sneakyginger/Silicone_dispenser/powerpoint/tussentijdse presentatie .pptx

## Silicone dispenser Gip midterm presentation

Piot David, Quackels Niels, Vandekerckhove Kamiel , Van Vlierberghe Gregor

## Introduction

- Probleemstelling : silicon gieten is vermoeiend .... Etc

Firw, Department of Mechanical Engineering

## Content

- Introduction
- Environment and constraints
- Functional decomposition
- Evaluation of ideas
- Current proposition
- Plan for after easter break

## Content

- Introduction
- Environment and constraints
- Functional decomposition
- Evaluation of ideas
- Current proposition
- Plan for semester

## Environment and constraints

- Wordt document met aannames en randvoorwaarden

## Content

- Introduction
- Environment and constraints
- Functional decomposition
- Evaluation of ideas
- Current proposition
- Plan for semester

## Functional decompostion

## Content

- Introduction
- Environment and constraints
- Functional decomposition
- Evaluation of ideas
- Current proposition
- Plan for semester 2

## Generating and Evaluating Ideas –

## Generating and Evaluating Ideas – Collection system

## Generating and Evaluating Ideas – Collection system

## Content

- Introduction
- Environment and constraints
- Functional decomposition
- Evaluation of ideas
- Current proposition
- Plan for semester 2

## Current Proposition

## Current Proposition

Temporarily closing

## Current Proposition

## Content

- Introduction
- Environment and constraints
- Functional decomposition
- Evaluation of ideas
- Current proposition
- Plan for semester 2

## Semester 2

- Dimensioning structures
- Specification of materials
- CAD modelling
- Detail presentation + final report and presentation
