sneakyginger/Silicone_dispenser/electronics/Presentation1.pptx

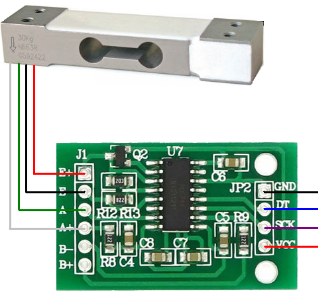
[picture p68: figure]
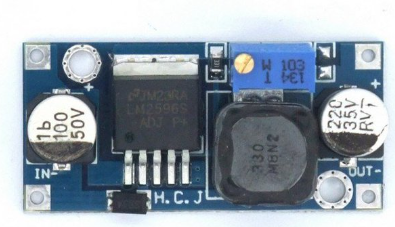
[picture p69: figure]
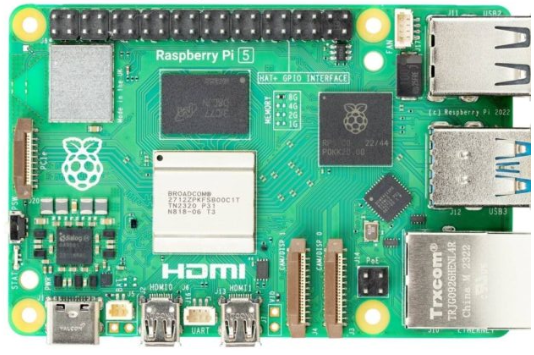
[picture p70: figure]
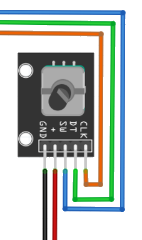
[picture p71: figure]
