sneakyginger/Silicone_dispenser/CAD/Electronics/Front_Perspective_1.JPG

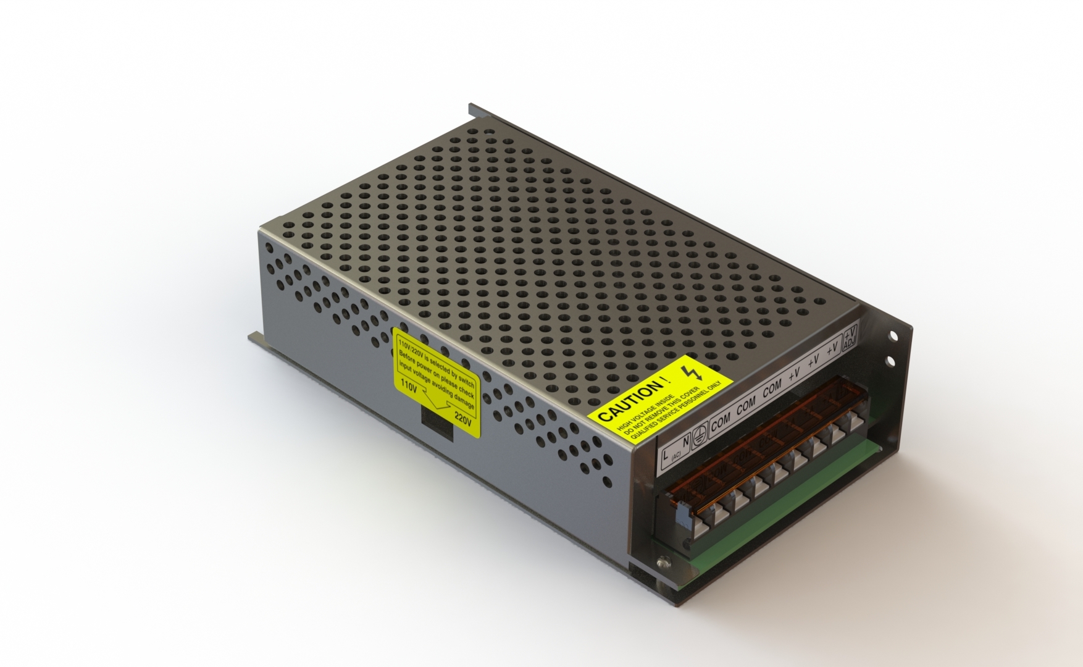
CAD/Electronics/Front_Perspective_1.JPG
