sneakyginger/Silicone_dispenser/CAD/Electronics/Lead Shine DM556.JPG

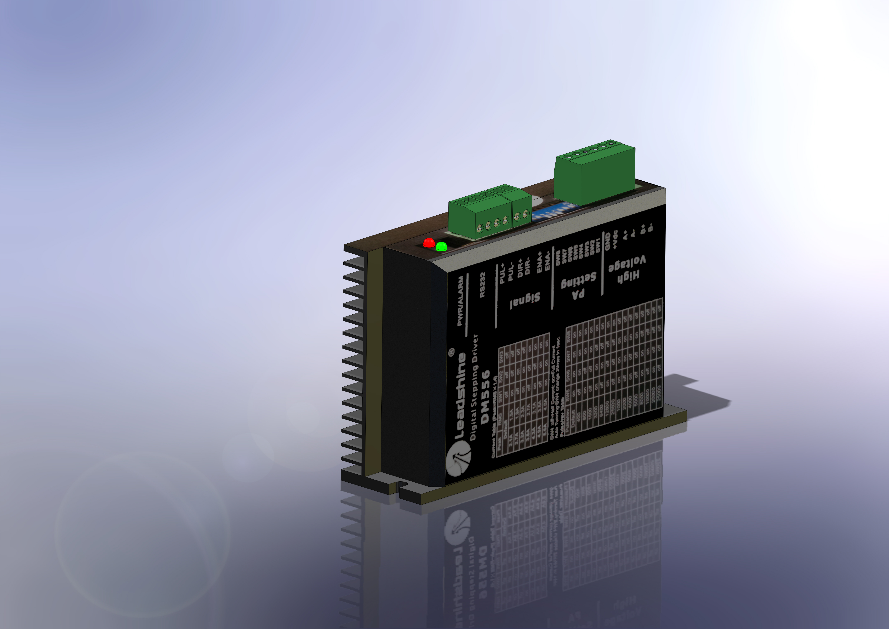
CAD/Electronics/Lead Shine DM556.JPG
