sneakyginger/Silicone_dispenser/CAD/Electronics/Rear_Perpective_2.JPG

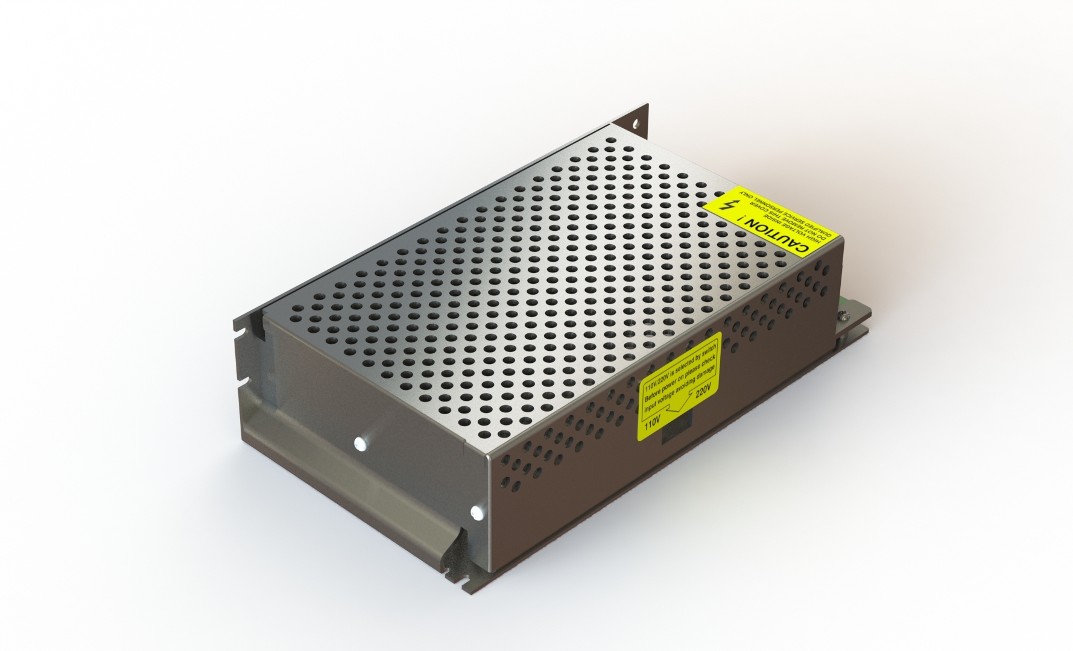
CAD/Electronics/Rear_Perpective_2.JPG
