sneakyginger/Silicone_dispenser/CAD/Electronics/Sticker_1.png

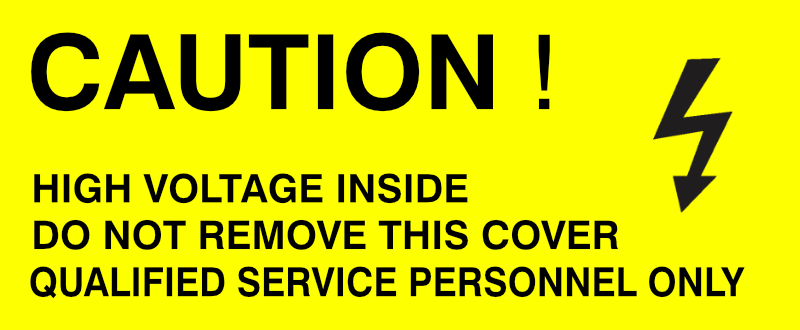
CAD/Electronics/Sticker_1.png
