sneakyginger/Silicone_dispenser/CAD/Electronics/Sticker_2.png

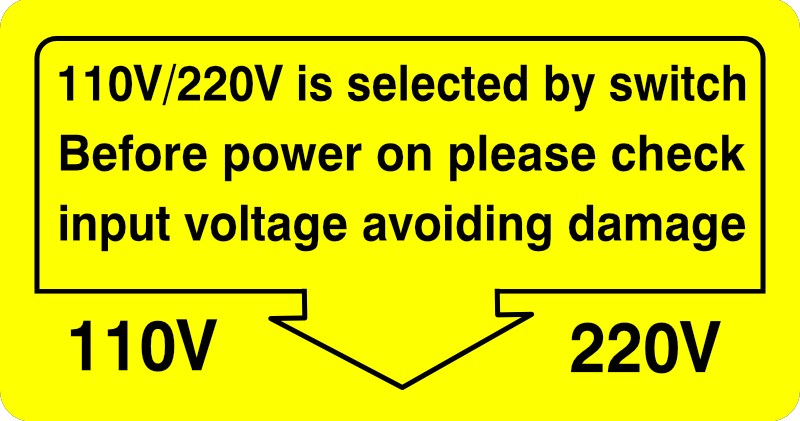
CAD/Electronics/Sticker_2.png
