sneakyginger/Silicone_dispenser/CAD/Weight sensor/DIGITAL LOAD CELL WITH RS485 OUTPUT.JPG

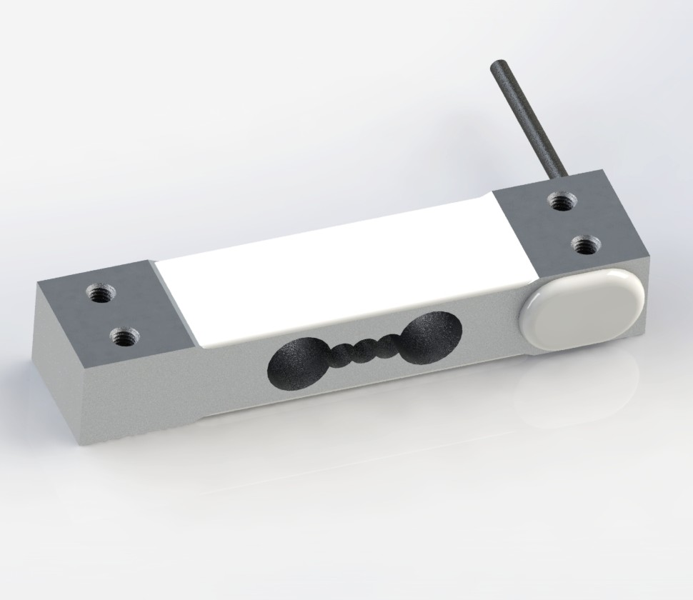
CAD/Weight sensor/DIGITAL LOAD CELL WITH RS485 OUTPUT.JPG
