sneakyginger/Silicone_dispenser/Interface/Sprites/bucket_big.png

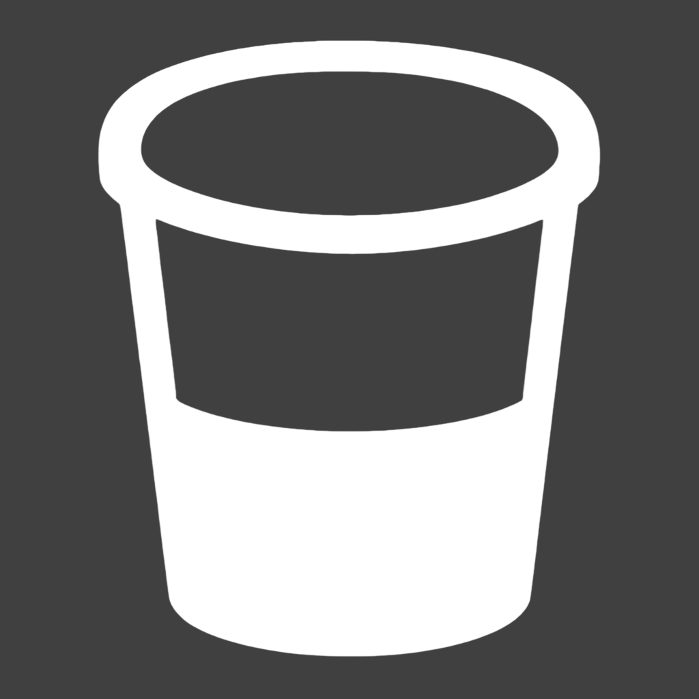
Interface/Sprites/bucket_big.png
