sneakyginger/Silicone_dispenser/Interface/Sprites/bucket_big_empty.png

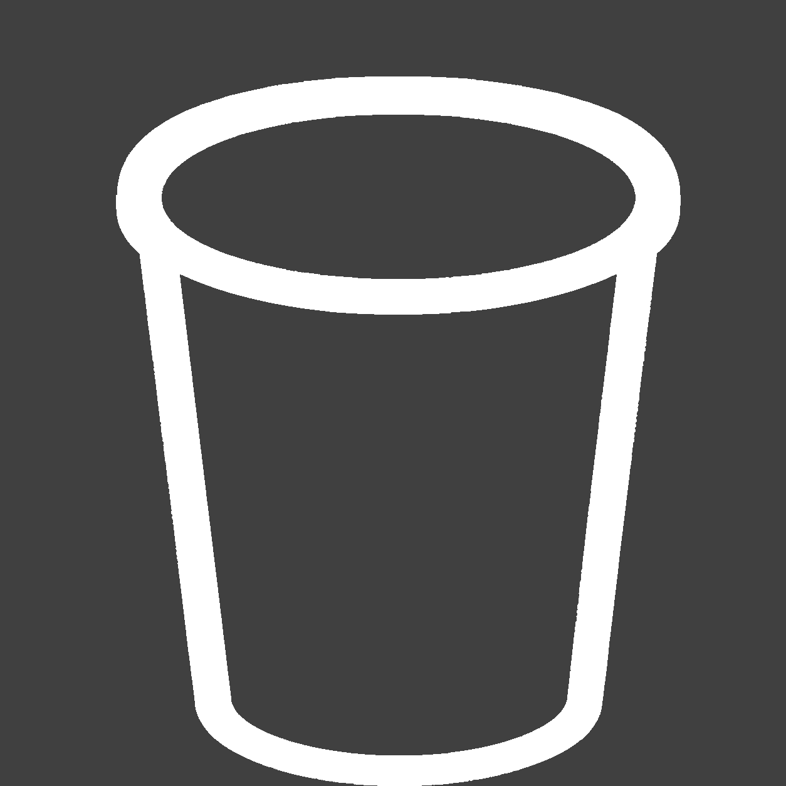
Interface/Sprites/bucket_big_empty.png
