sneakyginger/Silicone_dispenser/Interface/Sprites/button.png

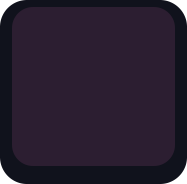
Interface/Sprites/button.png
