sneakyginger/Silicone_dispenser/Interface/Sprites/button_2comp_1.png

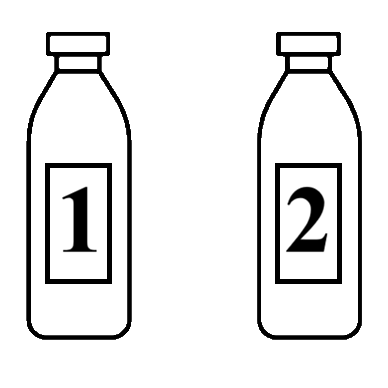
Interface/Sprites/button_2comp_1.png
