sneakyginger/Silicone_dispenser/Interface/Sprites/button_2comp_2.png

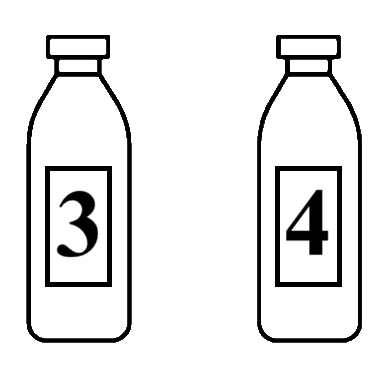
Interface/Sprites/button_2comp_2.png
