sneakyginger/Silicone_dispenser/Interface/Sprites/button_4comp.png

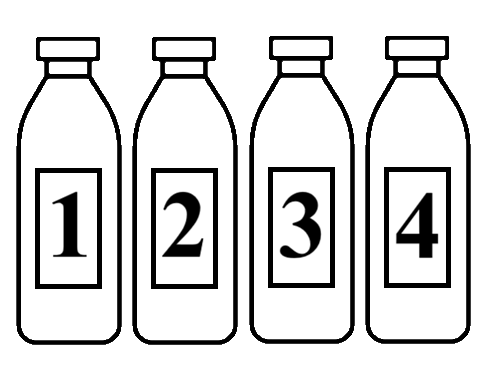
Interface/Sprites/button_4comp.png
