sneakyginger/Silicone_dispenser/Interface/Sprites/button_bottle_a.png

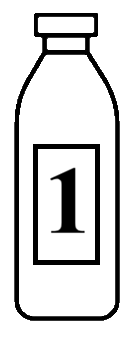
Interface/Sprites/button_bottle_a.png
