sneakyginger/Silicone_dispenser/Interface/Sprites/button_bottle_d.png

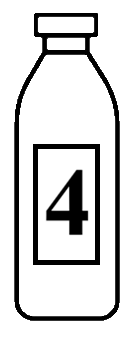
Interface/Sprites/button_bottle_d.png
