sneakyginger/Silicone_dispenser/Interface/Sprites/circulate.png

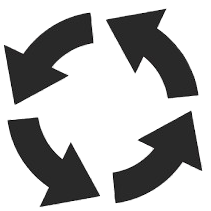
Interface/Sprites/circulate.png
