sneakyginger/Silicone_dispenser/Interface/Sprites/circulation_settings.png

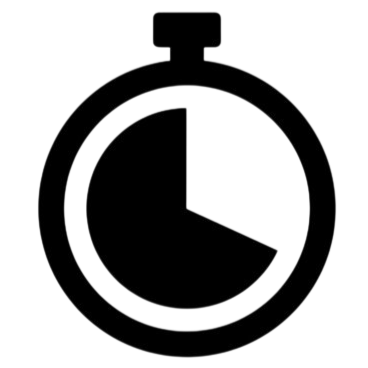
Interface/Sprites/circulation_settings.png
