sneakyginger/Silicone_dispenser/Interface/Sprites/cup_empty.png

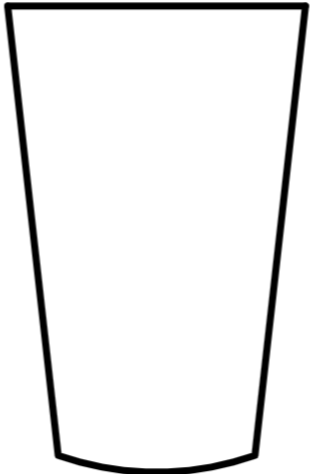
Interface/Sprites/cup_empty.png
