sneakyginger/Silicone_dispenser/Interface/Sprites/cup_full.png

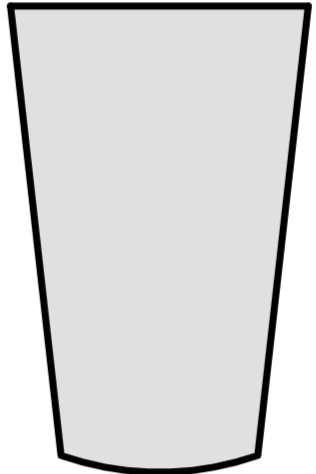
Interface/Sprites/cup_full.png
