sneakyginger/Silicone_dispenser/Interface/Sprites/cup_half.png

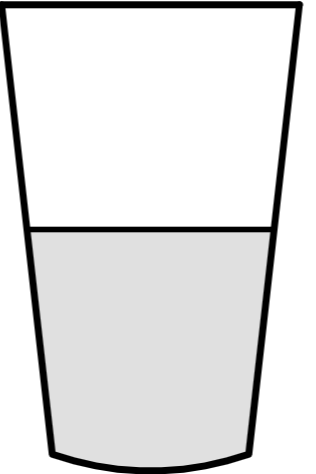
Interface/Sprites/cup_half.png
