sneakyginger/Silicone_dispenser/Interface/Sprites/no.png

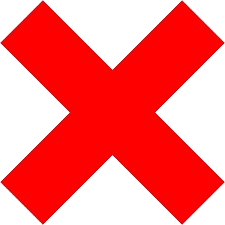
Interface/Sprites/no.png
