sneakyginger/Silicone_dispenser/Interface/Sprites/rond.png

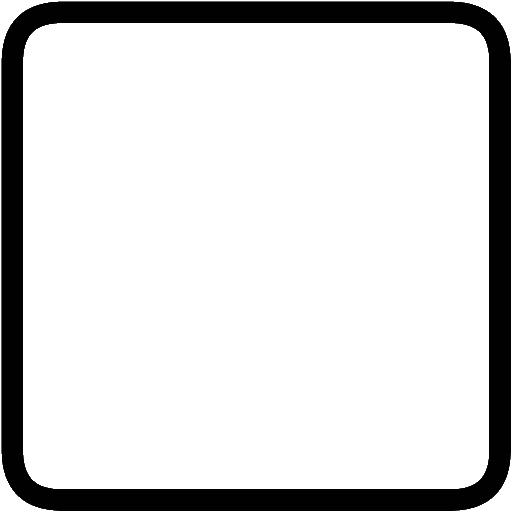
Interface/Sprites/rond.png
