sneakyginger/Silicone_dispenser/Interface/Sprites/yes.png

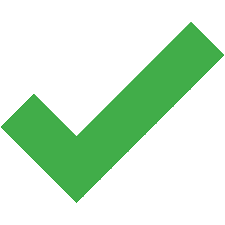
Interface/Sprites/yes.png
