sneakyginger/Silicone_dispenser/modellen/Framing_Tipping.drawio.png

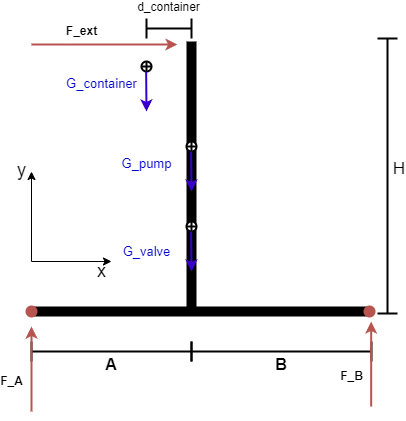
modellen/Framing_Tipping.drawio.png
