sneakyginger/Silicone_dispenser/Renders/Front View Container.drawio.png

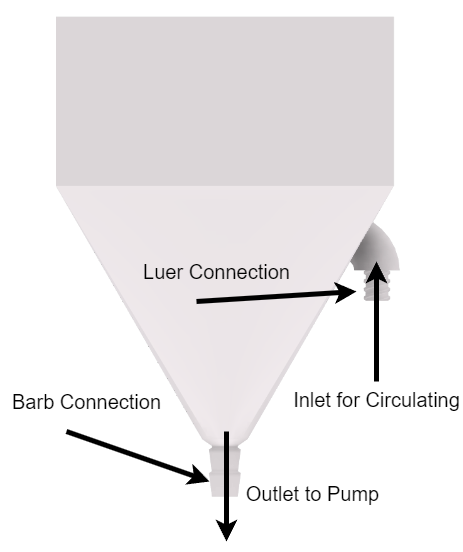
Renders/Front View Container.drawio.png
