sneakyginger/Silicone_dispenser/Renders/Front View Container.png

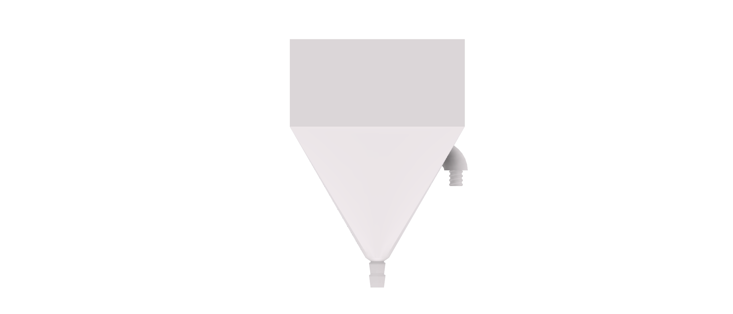
Renders/Front View Container.png
