sneakyginger/Silicone_dispenser/Renders/Full Design Render.1.png

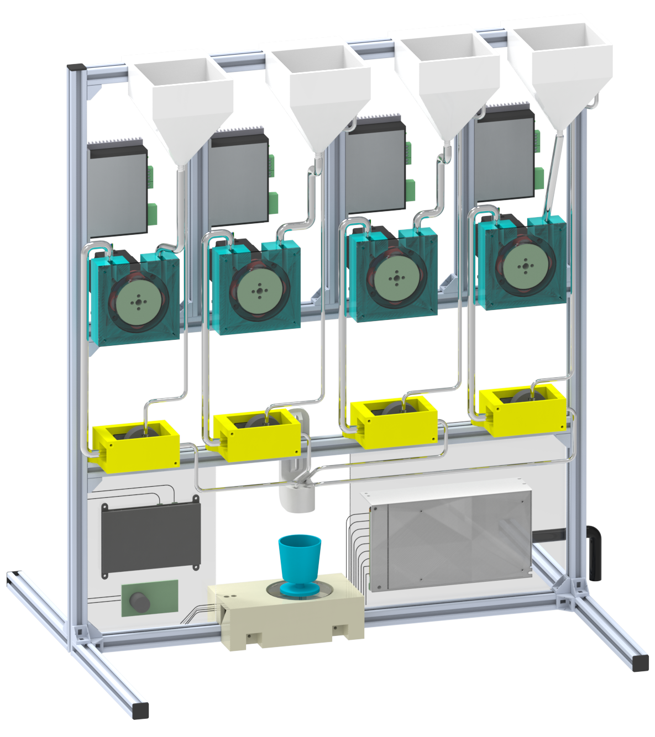
Renders/Full Design Render.1.png
