sneakyginger/Silicone_dispenser/Renders/Housing Isometric View.1.png

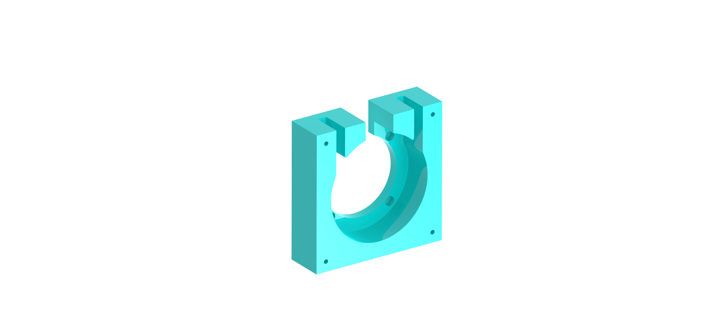
Renders/Housing Isometric View.1.png
