sneakyginger/Silicone_dispenser/Renders/Housing Isometric View.drawio.png

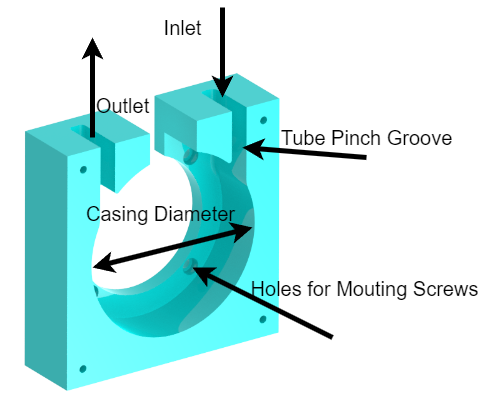
Renders/Housing Isometric View.drawio.png
