sneakyginger/Silicone_dispenser/Renders/Housing Pinch Groove.jpg

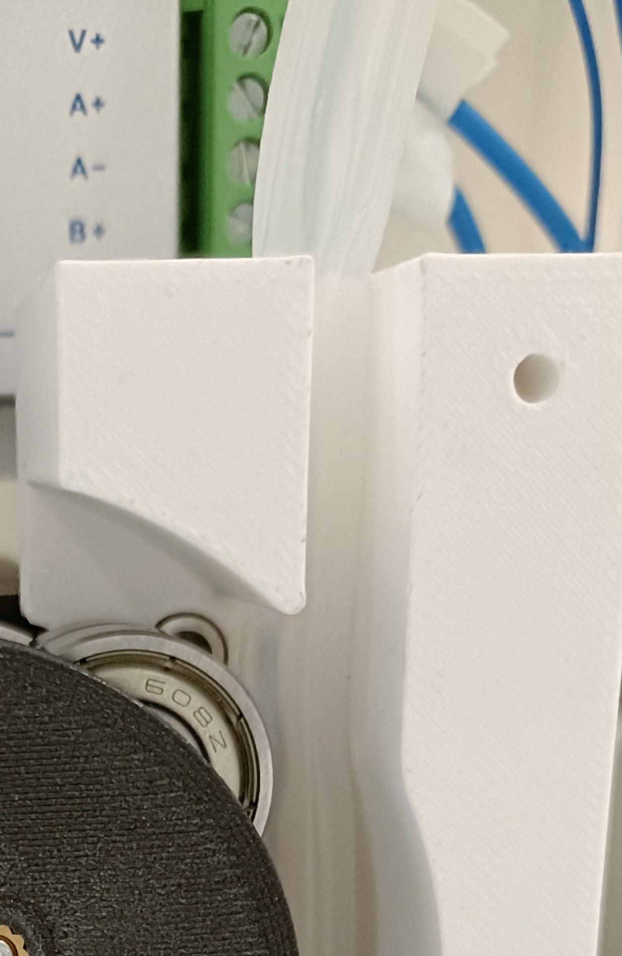
Renders/Housing Pinch Groove.jpg
