sneakyginger/Silicone_dispenser/Renders/Internal Section Gradual Restrictor.drawio.png

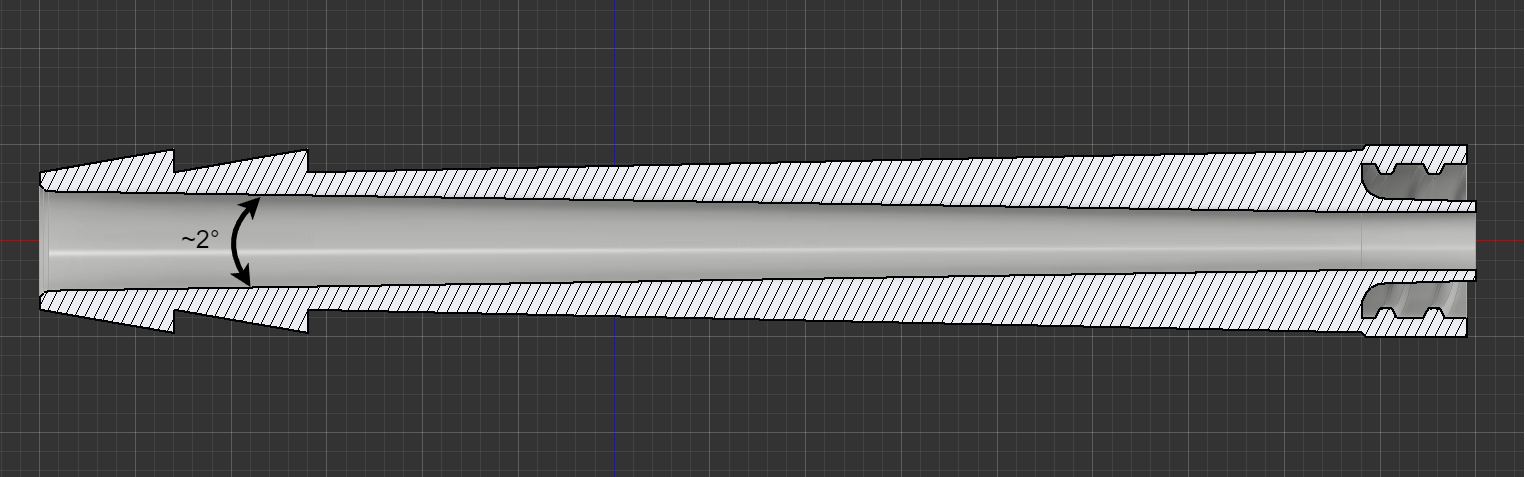
Renders/Internal Section Gradual Restrictor.drawio.png
