sneakyginger/Silicone_dispenser/Renders/Internal Section Gradual Restrictor.png

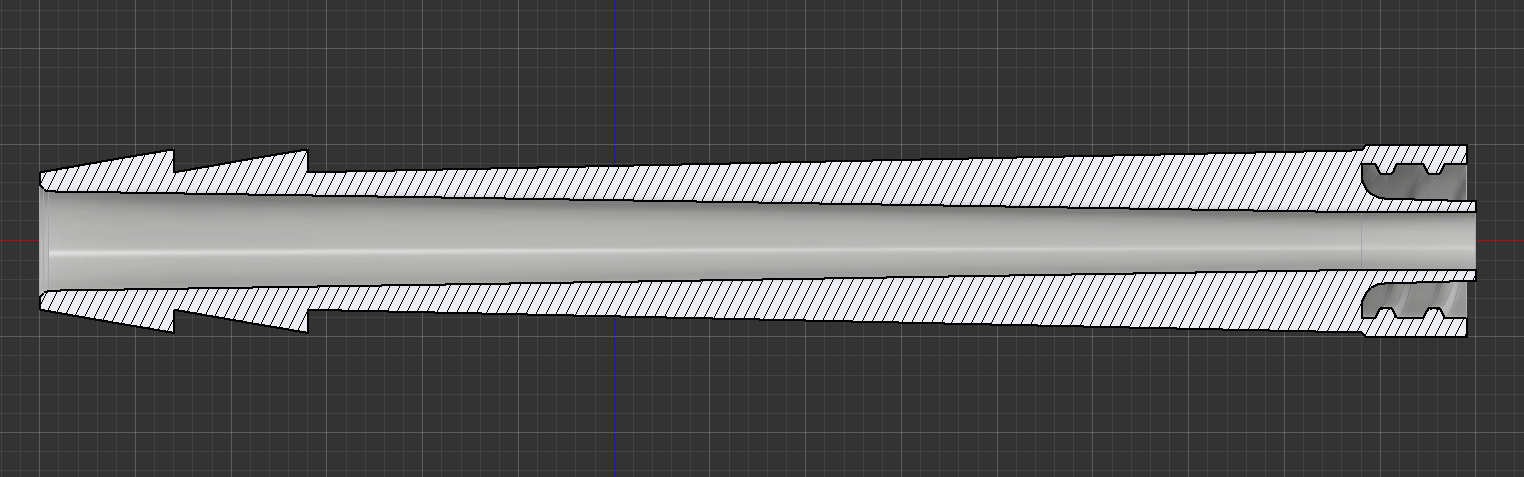
Renders/Internal Section Gradual Restrictor.png
