sneakyginger/Silicone_dispenser/Renders/Isometric View Container.drawio.png

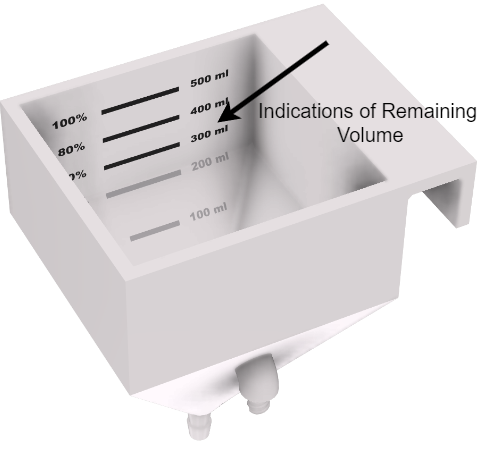
Renders/Isometric View Container.drawio.png
