sneakyginger/Silicone_dispenser/Renders/Isometric View Gradual Restrictor.drawio.png

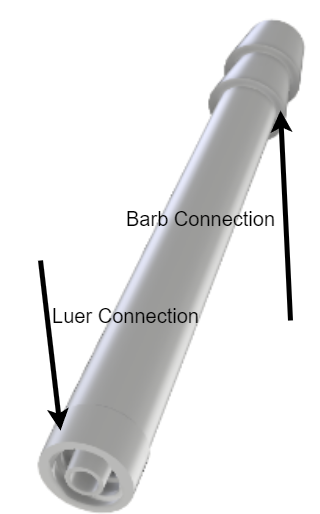
Renders/Isometric View Gradual Restrictor.drawio.png
