sneakyginger/Silicone_dispenser/Renders/Isometric View Gradual Restrictor.png

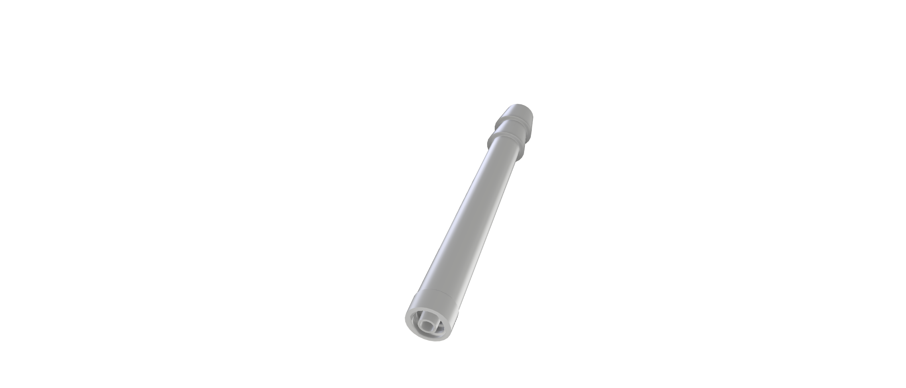
Renders/Isometric View Gradual Restrictor.png
