sneakyginger/Silicone_dispenser/Renders/Isometric View of Container.png

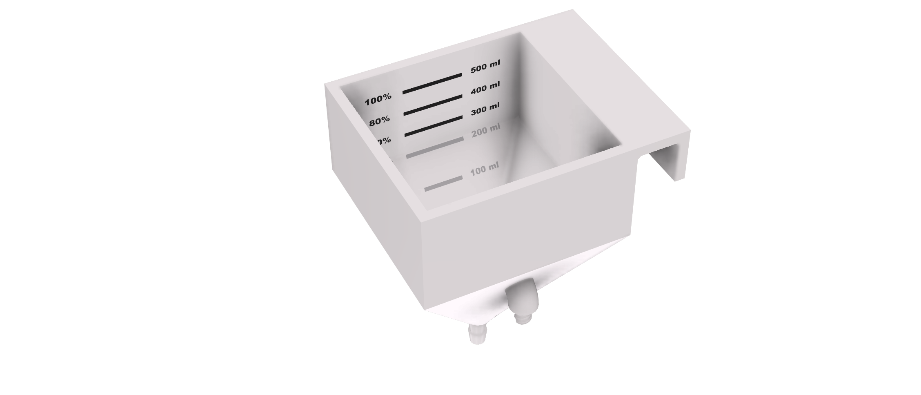
Renders/Isometric View of Container.png
