sneakyginger/Silicone_dispenser/Renders/Peristaltic Pump Isometric View.1.png

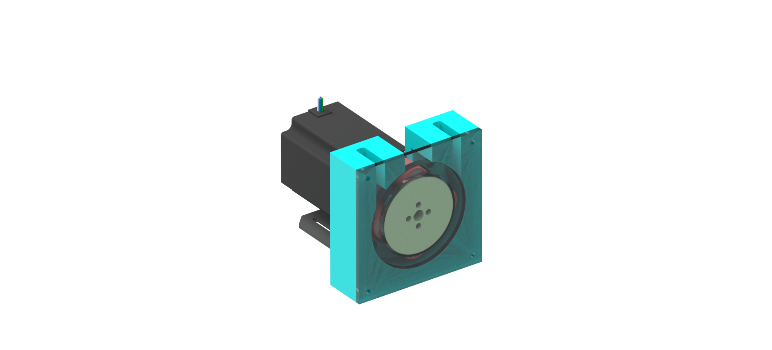
Renders/Peristaltic Pump Isometric View.1.png
