sneakyginger/Silicone_dispenser/Renders/Peristaltic Pump Isometric View.drawio.png

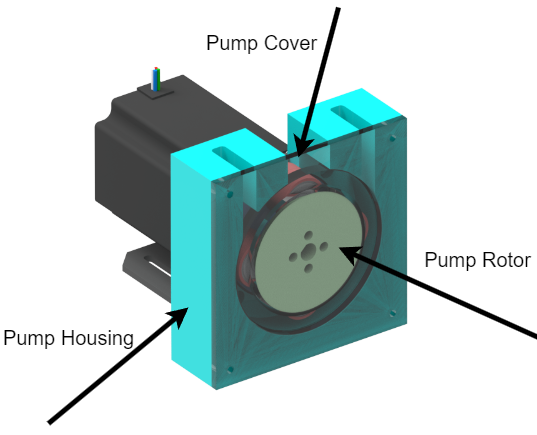
Renders/Peristaltic Pump Isometric View.drawio.png
