sneakyginger/Silicone_dispenser/Renders/Peristaltic Pump Side View.1.png

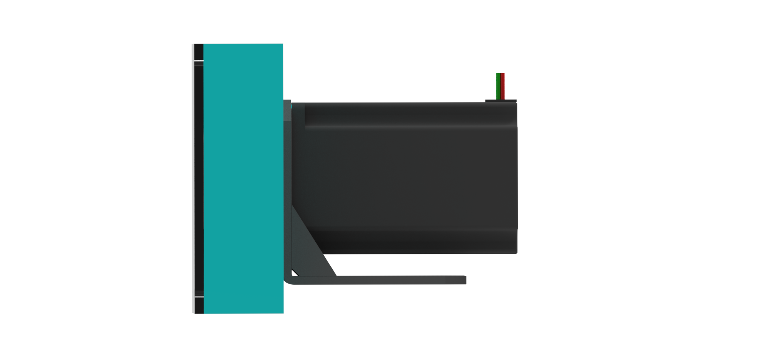
Renders/Peristaltic Pump Side View.1.png
