sneakyginger/Silicone_dispenser/Renders/Peristaltic Pump Side View.drawio.png

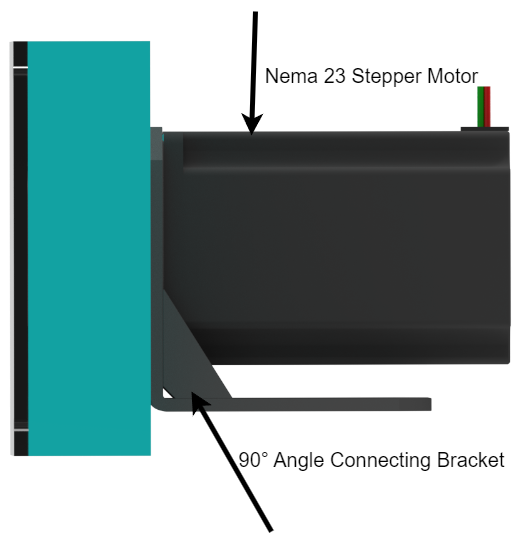
Renders/Peristaltic Pump Side View.drawio.png
