sneakyginger/Silicone_dispenser/Renders/Rotor Exploded View.1.png

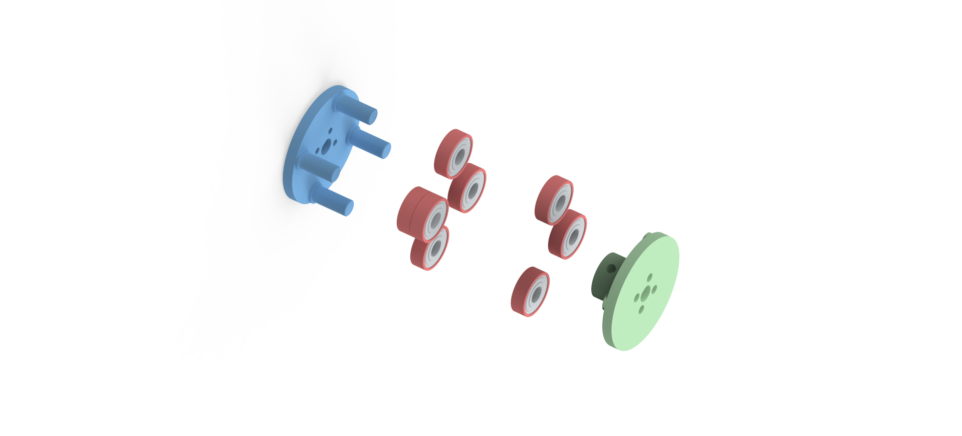
Renders/Rotor Exploded View.1.png
