sneakyginger/Silicone_dispenser/Renders/Rotor Exploded View.drawio.png

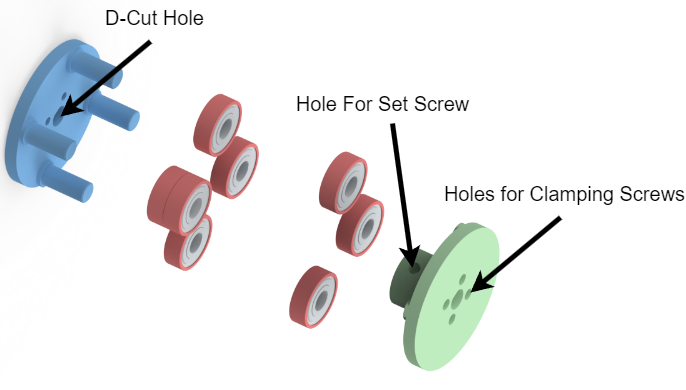
Renders/Rotor Exploded View.drawio.png
