sneakyginger/Silicone_dispenser/Renders/Rotor Isometric View.1.png

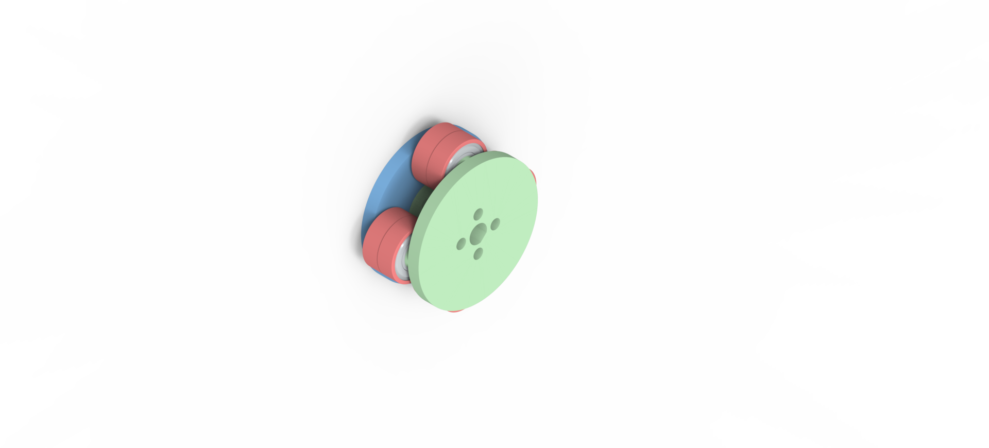
Renders/Rotor Isometric View.1.png
