sneakyginger/Silicone_dispenser/Renders/Rotor Isometric View.drawio.png

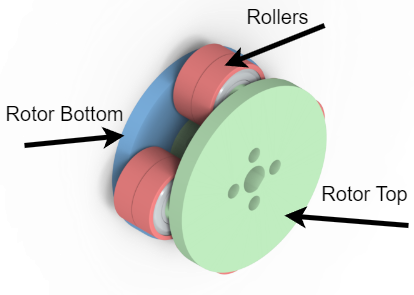
Renders/Rotor Isometric View.drawio.png
