sneakyginger/Silicone_dispenser/report/images/Flat Tube.drawio.png

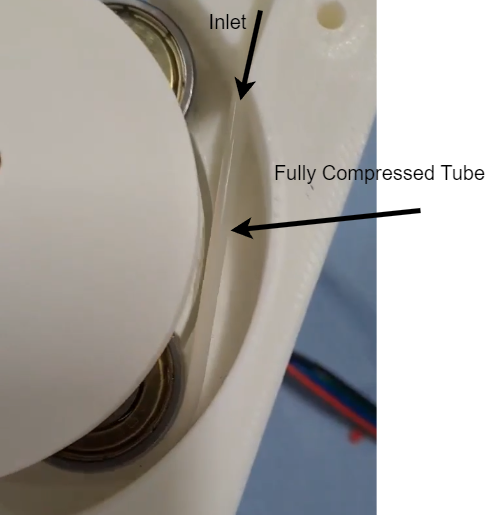
report/images/Flat Tube.drawio.png
