sneakyginger/Silicone_dispenser/report/images/Flat Tube.png

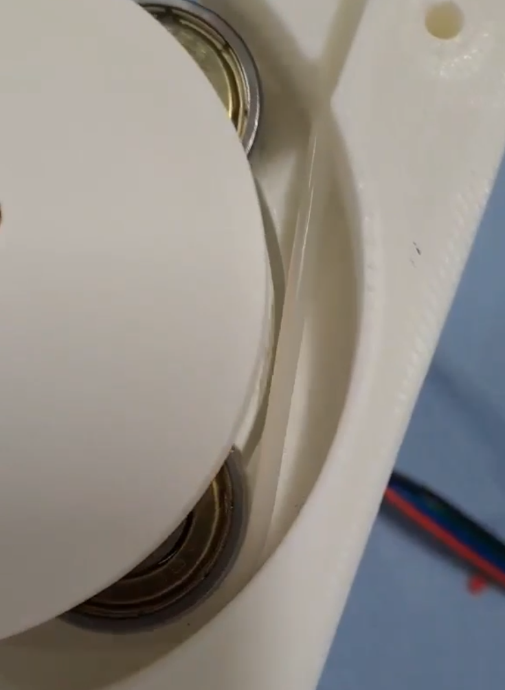
report/images/Flat Tube.png
