sneakyginger/Silicone_dispenser/report/images/functional decomposition.png

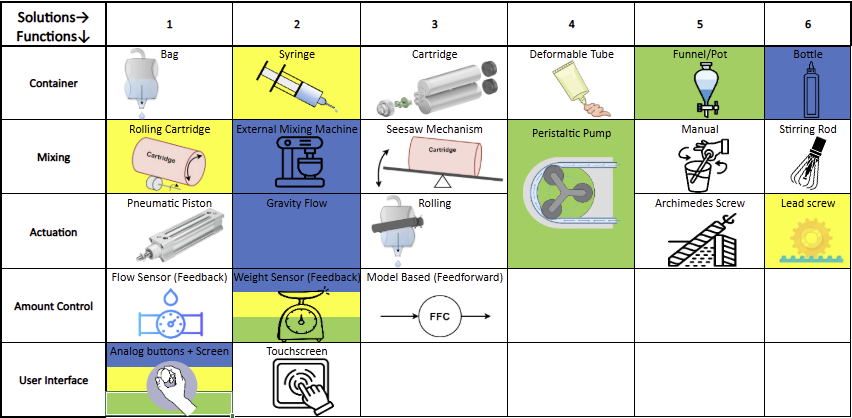
report/images/functional decomposition.png
