sneakyginger/Silicone_dispenser/report/images/gravity dispenser concept.drawio.png

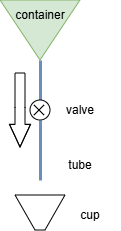
report/images/gravity dispenser concept.drawio.png
