sneakyginger/Silicone_dispenser/report/images/IMG20260603002009.jpg

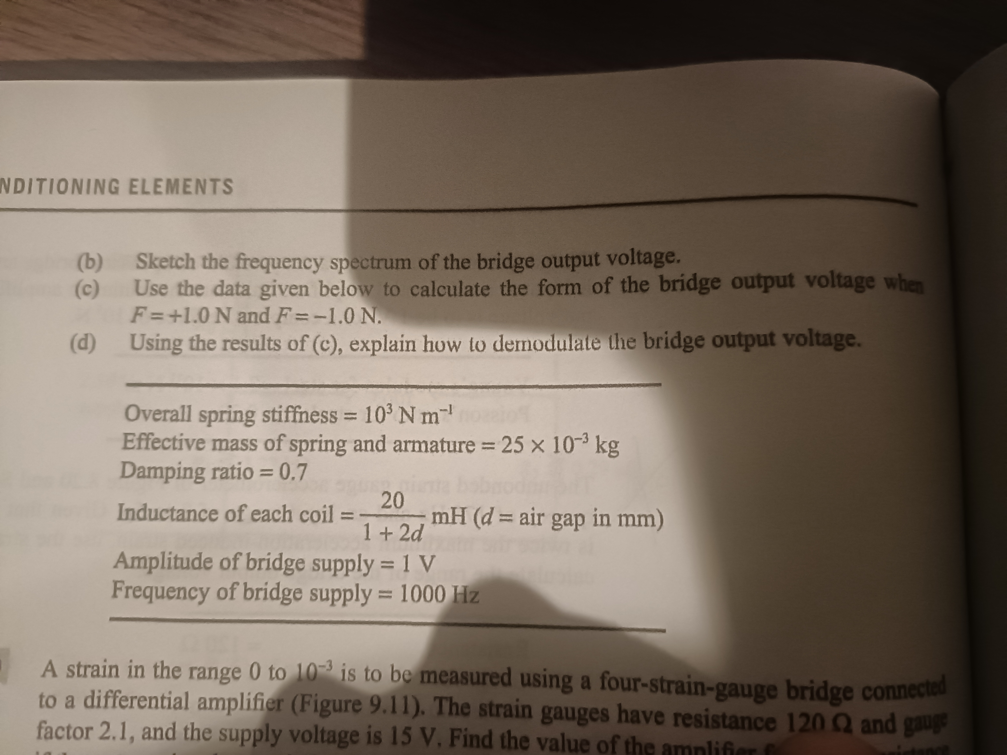
report/images/IMG20260603002009.jpg
