sneakyginger/Silicone_dispenser/report/images/peristaltic pump dispenser concept.png

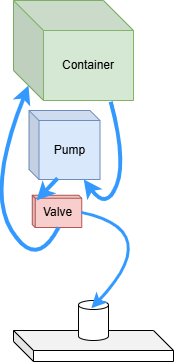
report/images/peristaltic pump dispenser concept.png
