sneakyginger/Silicone_dispenser/report/images/syringe dispenser concept.drawio.png

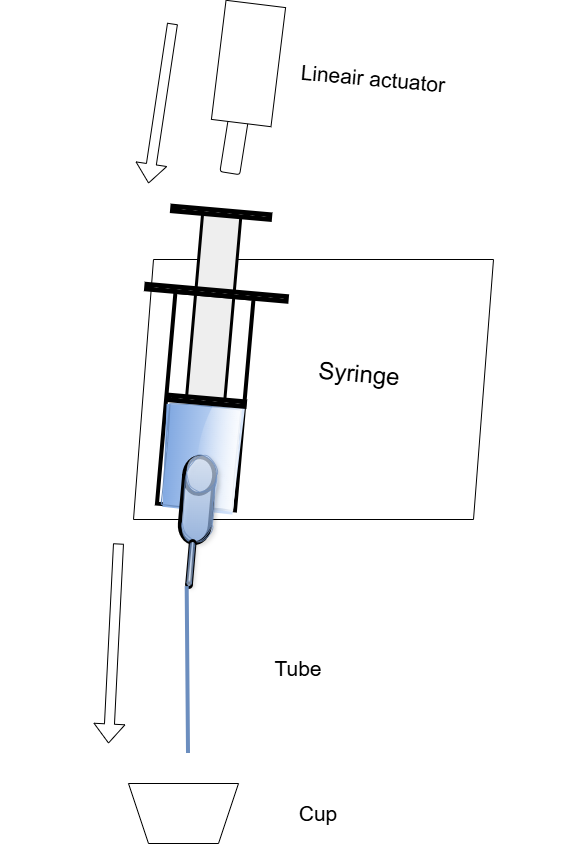
report/images/syringe dispenser concept.drawio.png
