sneakyginger/Silicone_dispenser/report/images/syringe dispenser concept.drawio.V2.png

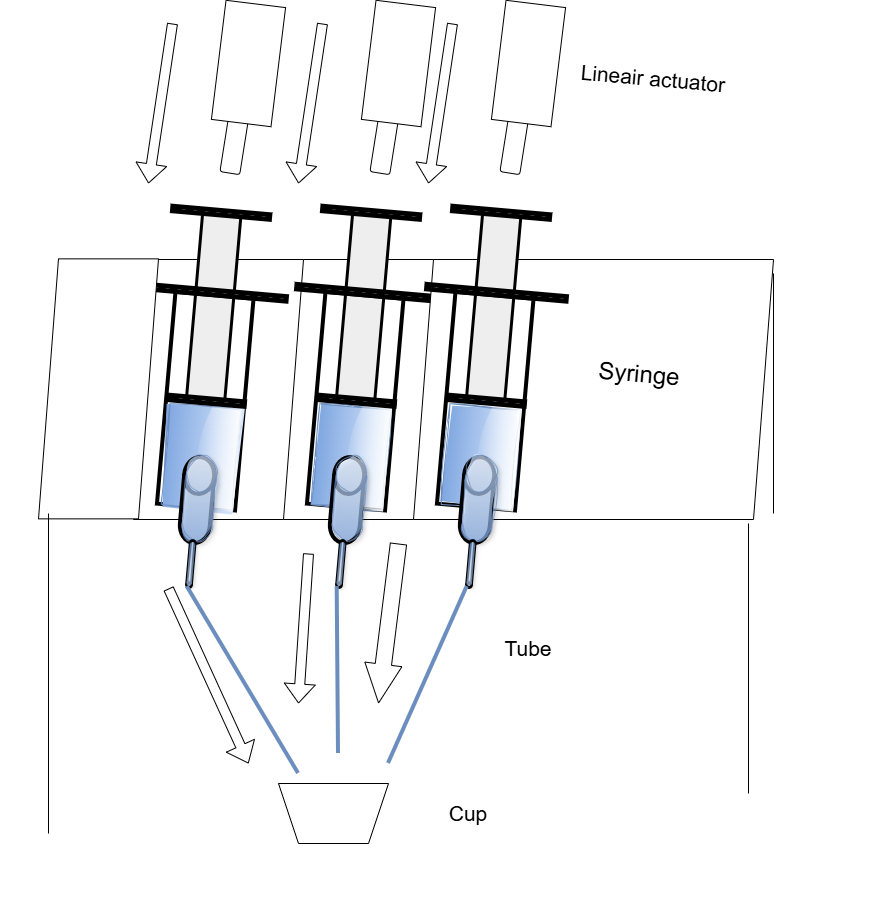
report/images/syringe dispenser concept.drawio.V2.png
