sneakyginger/Silicone_dispenser/report/images/value analysis .png

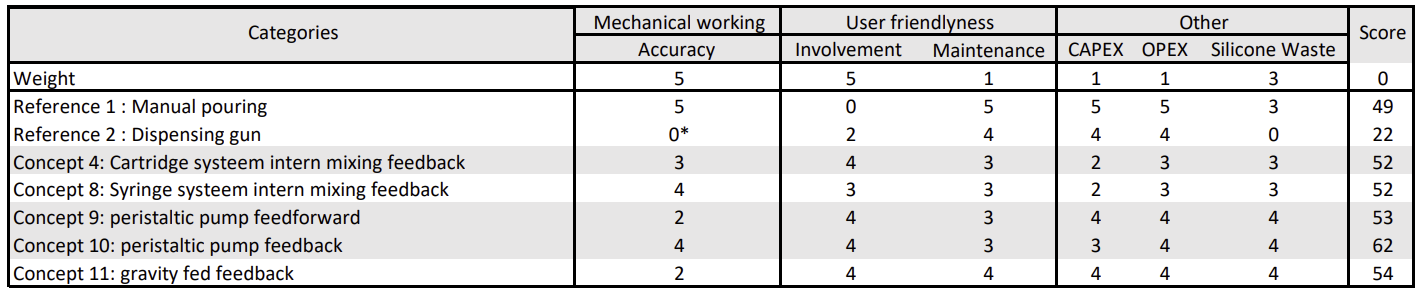
report/images/value analysis .png
