sneakyginger/Silicone_dispenser/powerpoint/frame list kamiel.xlsx

 |  | https://www.aluxprofiel.nl/aluminium-constructieprofiel-2020-v-slot/a3663?m=4257 | https://www.aluxprofiel.nl/aluminium-constructieprofiel-2020-v-slot/a3663?m=4257 | https://www.aluxprofiel.nl/aluminium-constructieprofiel-2020-v-slot/a3663?m=4257 | https://www.aluxprofiel.nl/verbindingshoek-2020/a3982?m=4297 | https://www.aluxprofiel.nl/indraaimoer-t-sleuf-8-m4/a3597?m=4282 | https://www.aluxprofiel.nl/afdekkap-2020/a3589 | acrylplaat
place | Component | Aluminium constructieprofiel 2020 V-slot 600 mm | Aluminium constructieprofiel 2020 V-slot 150 mm | Aluminium constructieprofiel 2020 V-slot 300 mm | Verbindingshoek 2020 | Indraaimoer. T-sleuf 8 M4 | Afdekkap 2020
Weight sensor |  | 1 | 0 | 0 | 0 | 2 | 0
Valves |  | 1 | 0 | 0 | 0 | 8 | 0
Pumps |  | 1 | 3 | 0 | 0 | 8 | 0
Container |  | 1 | 0 | 0 | 0 | 8 | 0
Frame |  | 2 | 0 | 4 | 22 | 16 | 6 | 190 X 600 en 4 driehoeken van 20 X 20
total |  | 6 | 3 | 4 | 22 | 42 | 6 | 190 X 600
 | component | link | lengte | hoeveelheid | prijs per stuk/ m | prijs
totaal | Aluminium constructieprofiel 2020 V-slot 600 mm | https://www.aluxprofiel.nl/aluminium-constructieprofiel-2020-v-slot/a3663?m=4257 | 600 | 7 | 5.49 | 23.058
 | Aluminium constructieprofiel 2020 V-slot 150 mm | https://www.aluxprofiel.nl/aluminium-constructieprofiel-2020-v-slot/a3663?m=4257 | 150 | 4 | 5.49 | 3.294
 | Aluminium constructieprofiel 2020 V-slot 300 mm | https://www.aluxprofiel.nl/aluminium-constructieprofiel-2020-v-slot/a3663?m=4257 | 300 | 5 | 5.49 | 8.235
 | Verbindingshoek 2020 | https://www.aluxprofiel.nl/aluminium-constructieprofiel-2020-v-slot/a3663?m=4257 | 0 | 25 | 0.29 | 7.25
 | Indraaimoer. T-sleuf 8 M4 | https://www.aluxprofiel.nl/verbindingshoek-2020/a3982?m=4297 | 0 | 45 | 0.16 | 7.2
 | Afdekkap 2020 | https://www.aluxprofiel.nl/afdekkap-2020/a3589 | 0 | 6 | 0.13 | 0.78
 |  |  |  |  |  | 49.817
