sneakyginger/Silicone_dispenser/CAD/Electronics/Ecran Raspberry Pi4  5 pouces 800x600.STEP

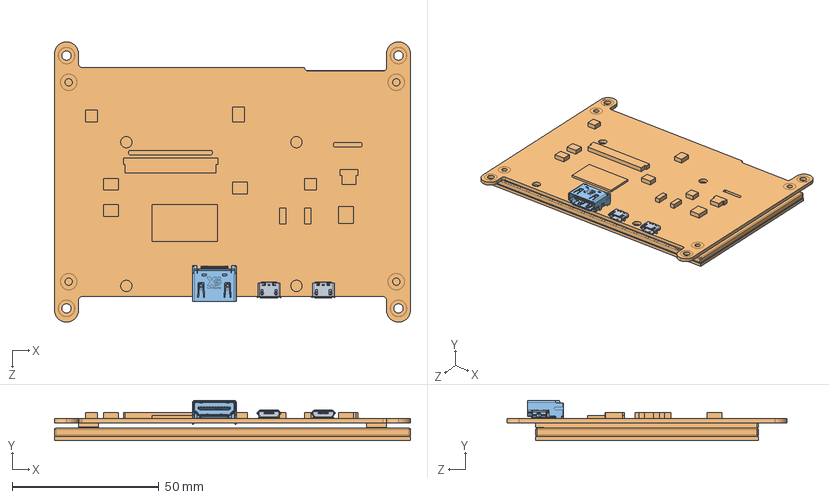
[picture p124: CAD file, 2026-05-17]
CAD/Electronics/Ecran Raspberry Pi4 5 pouces 800x600.STEP
121.4 x 13.8 x 95.6 mm
Carte + ecran
xb-cu11-sam10e0-nh
