sneakyginger/Silicone_dispenser/CAD/Peristaltic_Pump/Nema 23 Pomp/NEMA 23 84mm Frame Stepper Motor.step

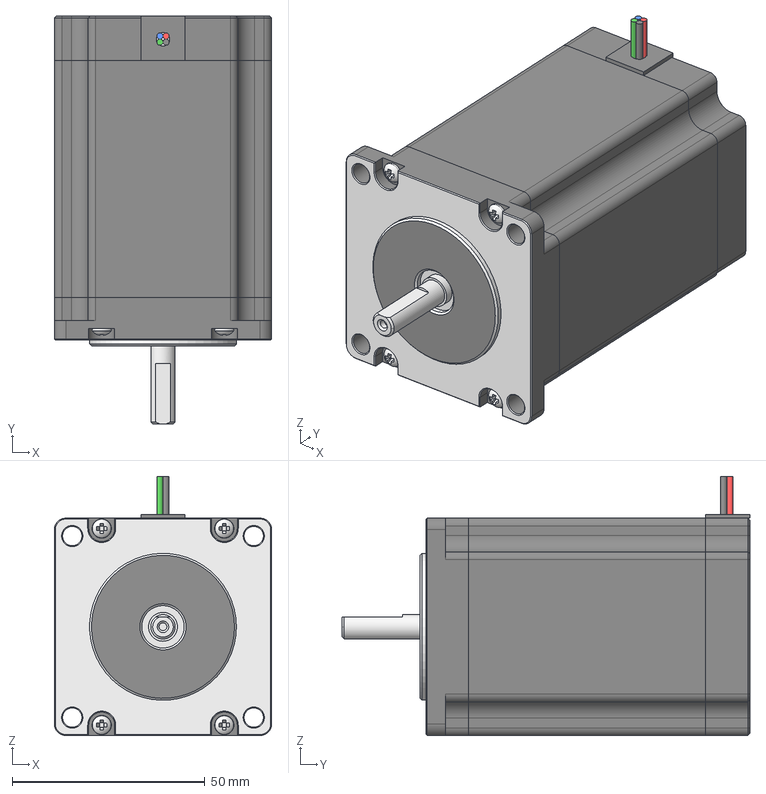
[picture p125: CAD file, 2026-05-15]
CAD/Peristaltic_Pump/Nema 23 Pomp/NEMA 23 84mm Frame Stepper Motor.step
56.4 x 105.8 x 67.2 mm
Main Body
Cap
Screw 2
Screw 3
Screw 4
Strain Relief
Armature
Wire - Black
Screw 1
Wire - Green
Wire - Blue
Wire - Red
