sneakyginger/Silicone_dispenser/CAD/Valve circulation system/Valve circulation top.stl

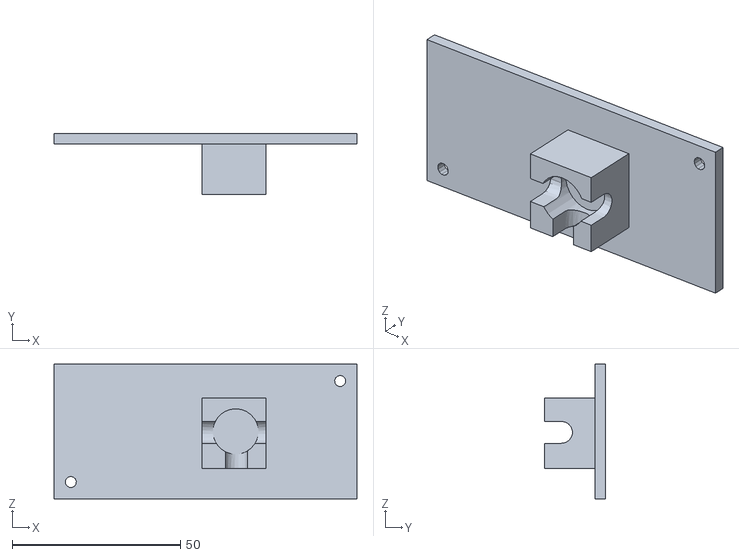
[picture p126: CAD file, 2026-05-07]
CAD/Valve circulation system/Valve circulation top.stl
90.0 x 18.0 x 40.0
