sneakyginger/Silicone_dispenser/CAD/Weight sensor/weight sensor casing V7.stl

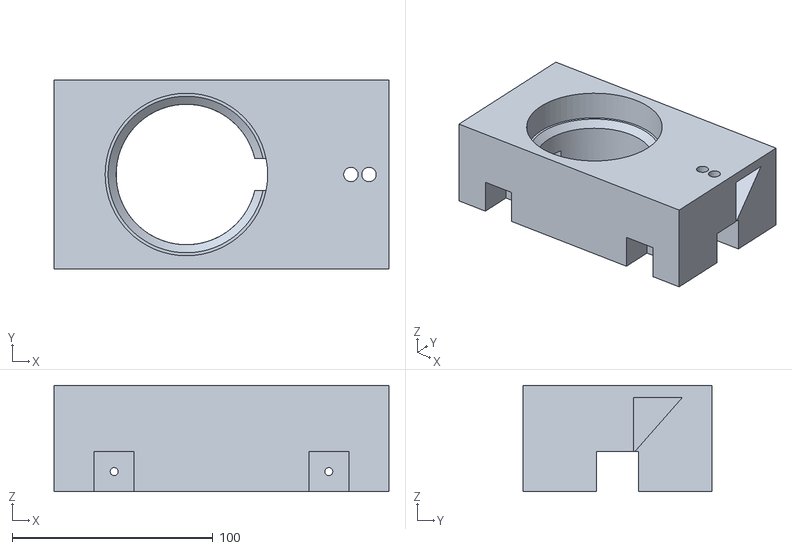
[picture p127: CAD file, 2026-05-15]
CAD/Weight sensor/weight sensor casing V7.stl
167.0 x 94.0 x 53.0
