sneakyginger/Silicone_dispenser/CAD/Electronics/PowerSupply_48V_DC_5A.STEP

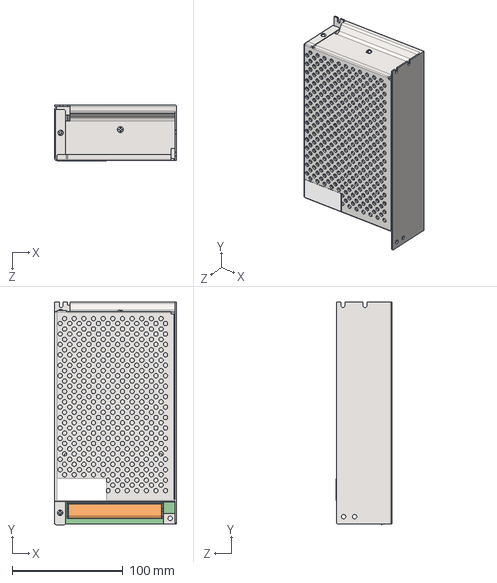
[picture p128: CAD file, 2026-05-17]
CAD/Electronics/PowerSupply_48V_DC_5A.STEP
110.2 x 201.0 x 50.2 mm
