sneakyginger/Silicone_dispenser/CAD/Valve circulation system/Valve circulation tussenstuk.stl

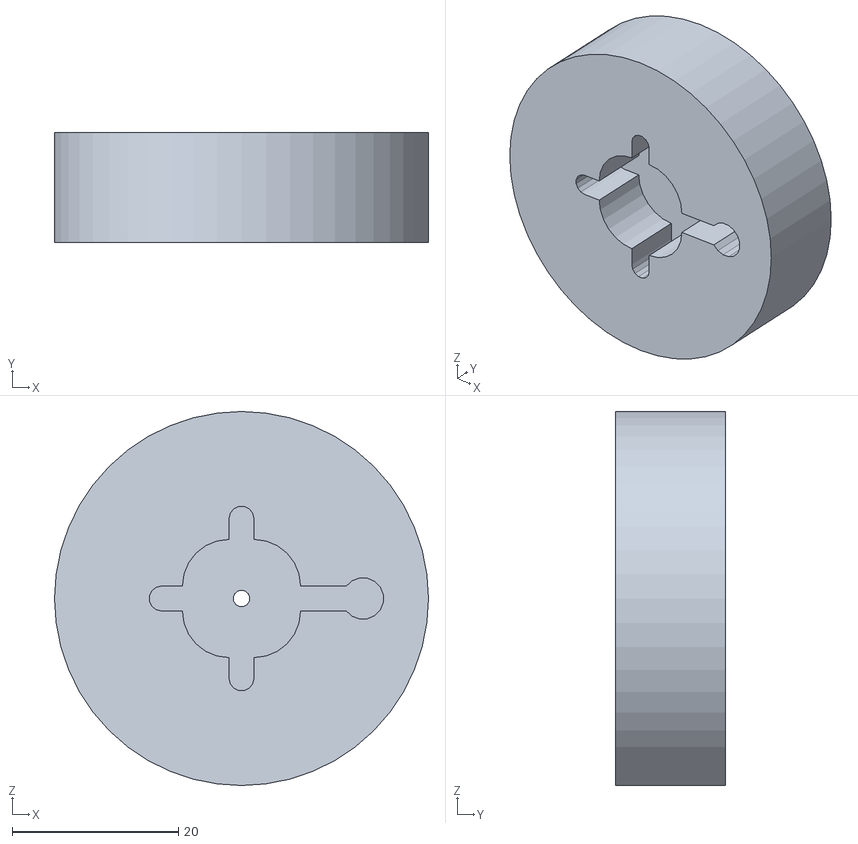
[picture p129: CAD file, 2026-05-07]
CAD/Valve circulation system/Valve circulation tussenstuk.stl
45.0 x 13.2 x 45.0
