sneakyginger/Silicone_dispenser/CAD/Weight sensor/HAND INJECTION MOULD.stp

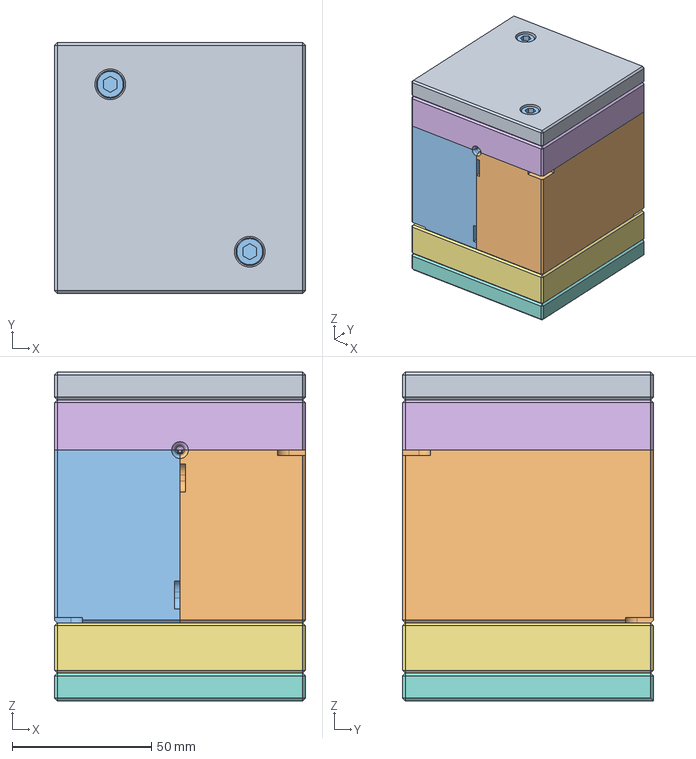
[picture p130: CAD file, 2026-04-02]
CAD/Weight sensor/HAND INJECTION MOULD.stp
90.0 x 90.0 x 118.0 mm
