sneakyginger/Silicone_dispenser/CAD/Electronics/VTX-212-150-0xx.STEP

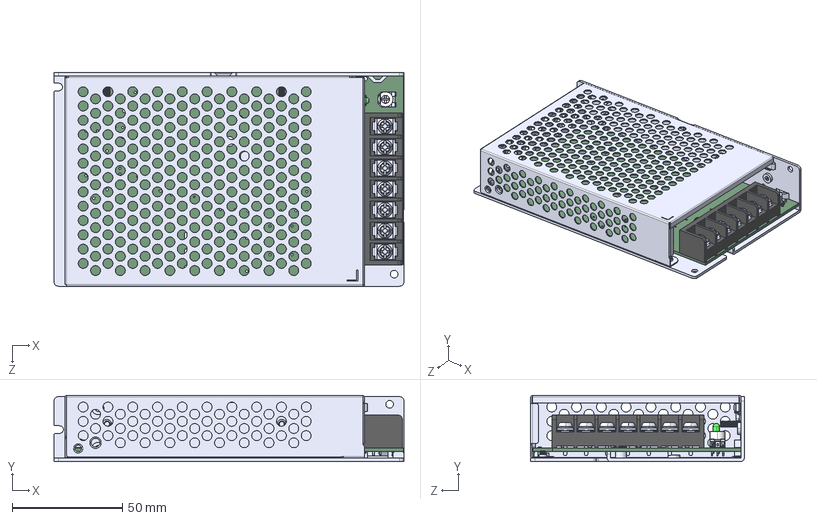
[picture p131: CAD file, 2026-05-17]
CAD/Electronics/VTX-212-150-0xx.STEP
159.0 x 30.0 x 97.0 mm
CHASSIS_1
SCREW_5_1
COVER_9
PRT0084_1
PRT0102_1
PRT0114_1
PRT0115_1 x 16
PRT0116_1 x 16
PRT0117_1 x 16
PRT0124_1
SCREW_YT_1 x 2
M3X8_16_1
DP_2_1
TH_5_1
SCREW_CHASSIS_1
