sneakyginger/Silicone_dispenser/CAD/Weight sensor/RTUB.STEP

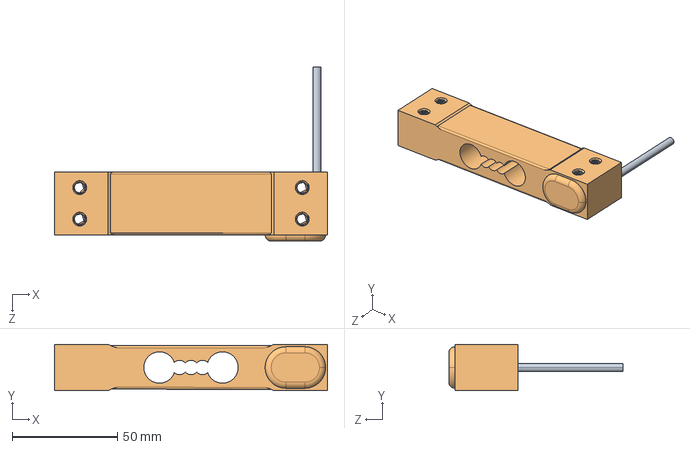
[picture p132: CAD file, 2026-04-02]
CAD/Weight sensor/RTUB.STEP
130.0 x 22.0 x 83.0 mm
