sneakyginger/Silicone_dispenser/CAD/Electronics/Lead Shine DM556.STEP

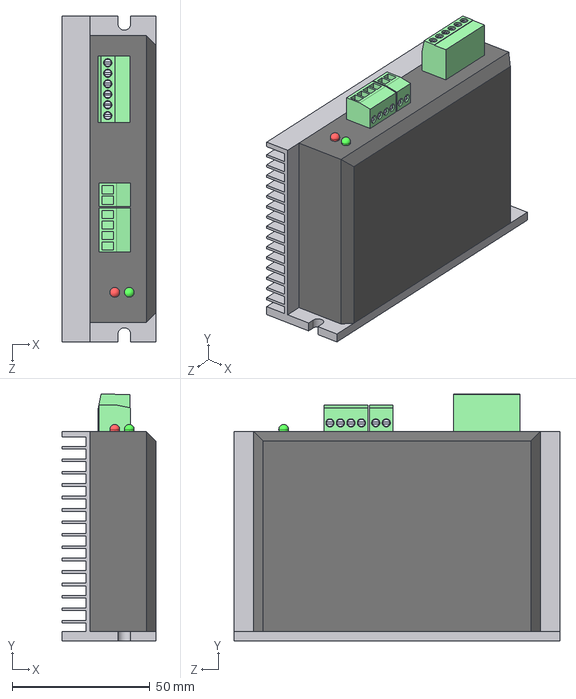
[picture p133: CAD file, 2026-05-15]
CAD/Electronics/Lead Shine DM556.STEP
34.0 x 89.5 x 118.0 mm
