sneakyginger/Silicone_dispenser/CAD/Valve circulation system/Valve circulation bottom.stl

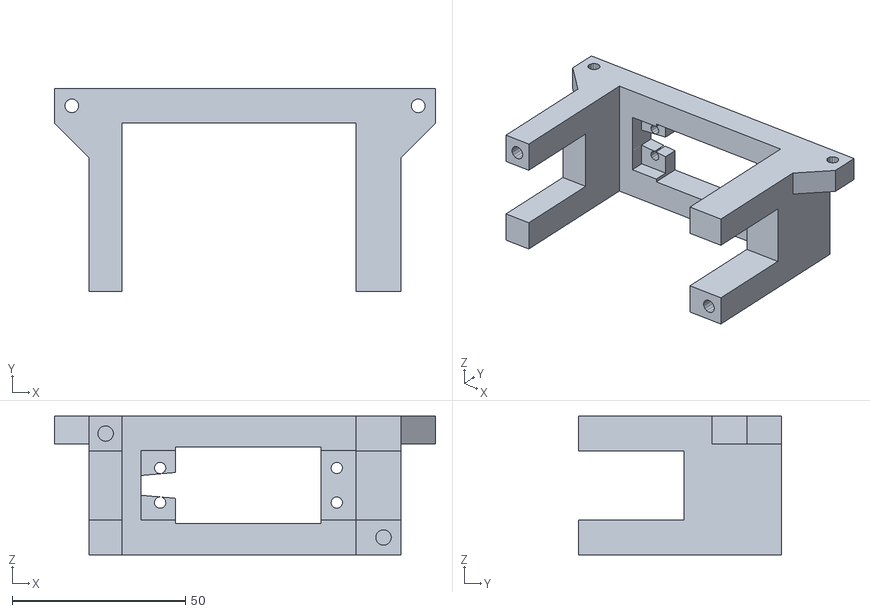
[picture p134: CAD file, 2026-05-07]
CAD/Valve circulation system/Valve circulation bottom.stl
110.0 x 58.6 x 40.0
