sneakyginger/Silicone_dispenser/CAD/Valve circulation system/servo holder V14.stl

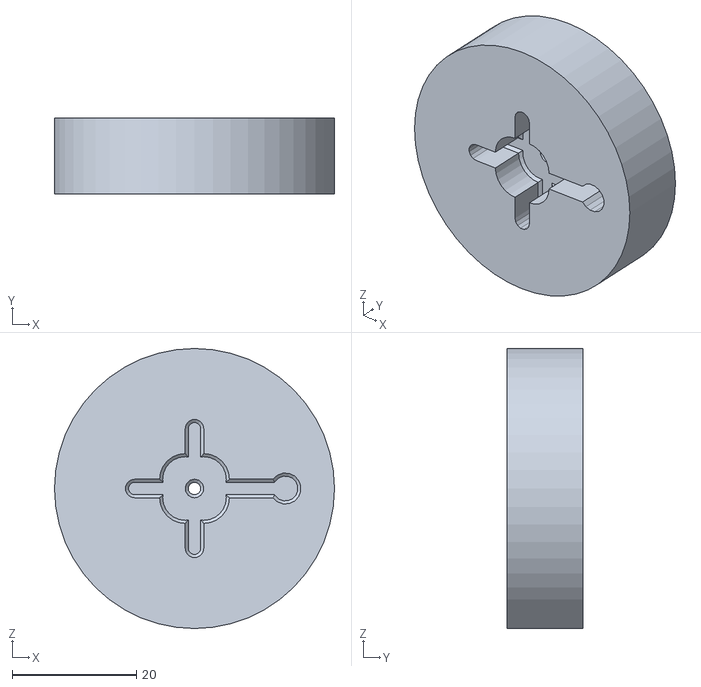
[picture p135: CAD file, 2026-05-07]
CAD/Valve circulation system/servo holder V14.stl
45.0 x 12.2 x 45.0
