sneakyginger/Silicone_dispenser/CAD/Valve circulation system/servo mounting v4.stl

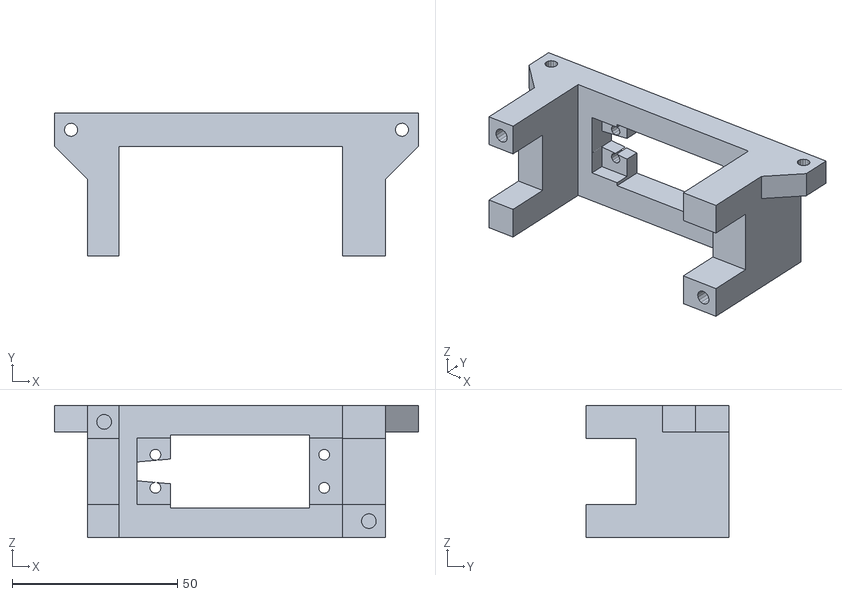
[picture p136: CAD file, 2026-03-25]
CAD/Valve circulation system/servo mounting v4.stl
110.0 x 43.1 x 40.0
