sneakyginger/Silicone_dispenser/CAD/Valve circulation system/servo holder V12.stl

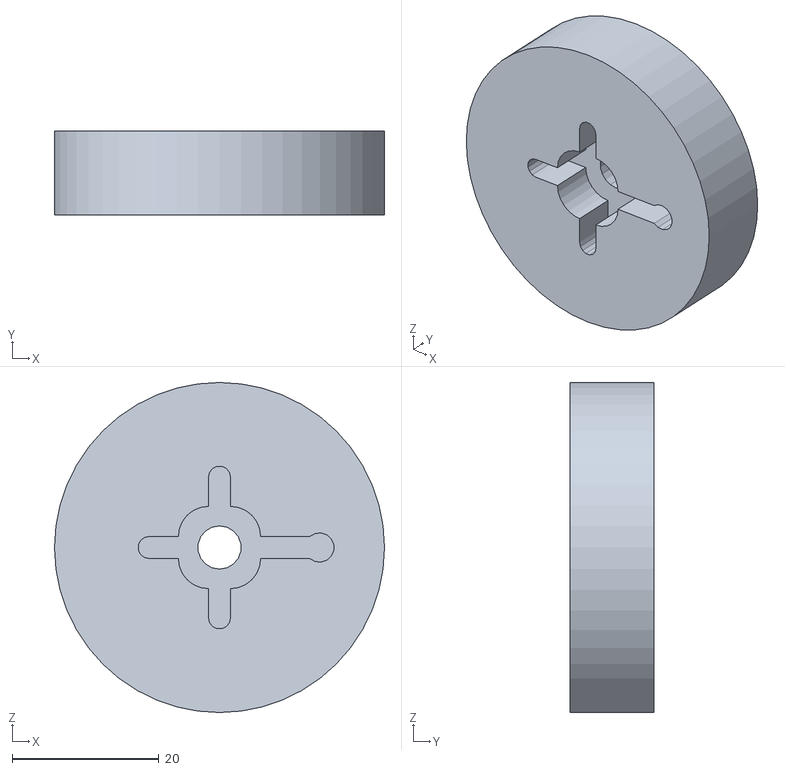
[picture p137: CAD file, 2026-05-07, an earlier design]
CAD/Valve circulation system/servo holder V12.stl
45.0 x 11.5 x 45.0
