sneakyginger/Silicone_dispenser/CAD/Valve circulation system/servo holder V13.stl

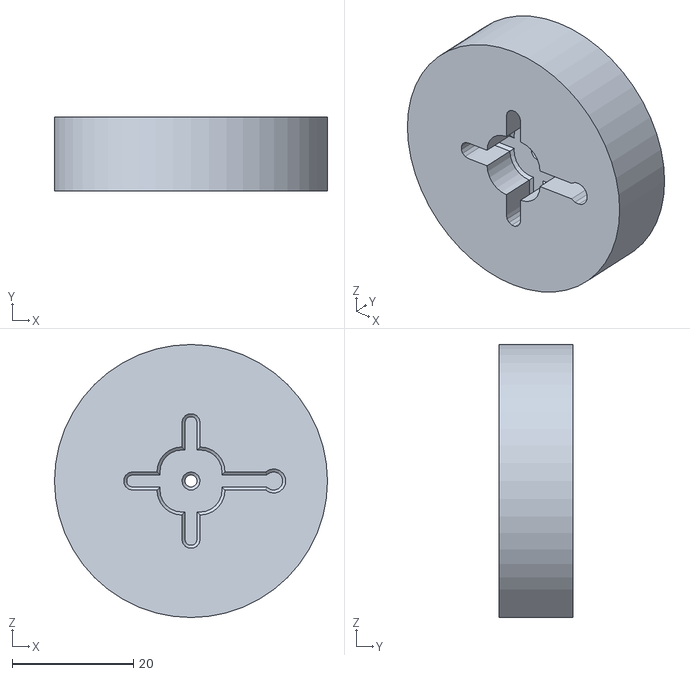
[picture p138: CAD file, 2026-05-07, an earlier design]
CAD/Valve circulation system/servo holder V13.stl
45.0 x 12.2 x 45.0
