sneakyginger/Silicone_dispenser/CAD/Valve circulation system/servo holder v4.stl

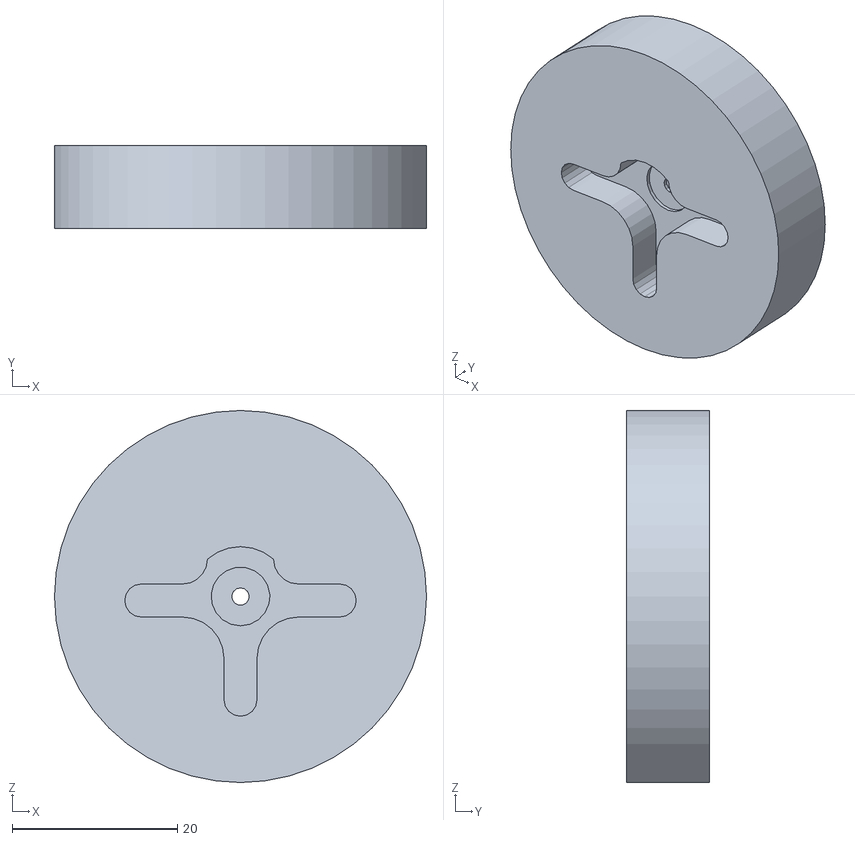
[picture p139: CAD file, 2026-03-25, an earlier design]
CAD/Valve circulation system/servo holder v4.stl
45.0 x 10.0 x 45.0
