sneakyginger/Silicone_dispenser/CAD/Valve circulation system/Valve holder v3.stl

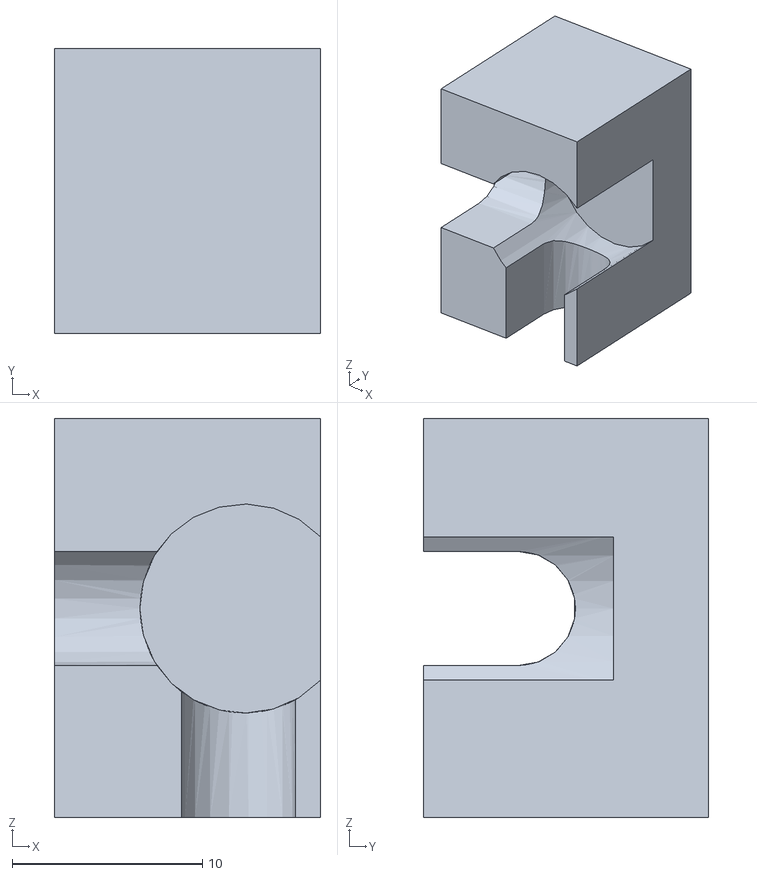
[picture p140: CAD file, 2026-03-20, an earlier design]
CAD/Valve circulation system/Valve holder v3.stl
14.0 x 15.0 x 21.0
