sneakyginger/Silicone_dispenser/(list of files, cad)

Other CAD files:
CAD/Container/Cover Silicone Container.f3d
CAD/Container/Silicone Container.f3d
CAD/Peristaltic_Pump/Nema 23 Pomp/NEMA 23 84mm Frame Stepper Motor.FCStd
CAD/Valve circulation system/servo holder v2.stl
CAD/Valve circulation system/servo holder.stl
CAD/Varia (Luer Connectors, Restrictor...)/5mm-3mm Restrictor.f3d
CAD/Varia (Luer Connectors, Restrictor...)/Luer Connector Female Lock.f3d
CAD/Varia (Luer Connectors, Restrictor...)/Luer Connector Male Lock.f3d
CAD/Varia (Luer Connectors, Restrictor...)/Restrictor Holder.f3d
CAD/Weight sensor/PART.prt
MAP ALEXIS/Container/Cover Silicone Container.f3d
MAP ALEXIS/Container/Silicone Container.f3d
MAP ALEXIS/Restrictor/5mm-3mm Restrictor.f3d
