sneakyginger/Silicone_dispenser/Interface/arduino/stepper_arduino/stepper_arduino.ino

const int PIN = 11;
const int DR_PIN = 12;
const int MF_PIN = 13;
//zet hier u RPM
const float RPM = 20;
float steps = RPM*200/60;
//schrijf hier hoeveel microsteps aanstaan
int microsteps = 1;
float halfPeriod;
float state;
float FREQ;
void setup() {
  pinMode(PIN, OUTPUT);
  pinMode(MF_PIN, OUTPUT);
  pinMode(DR_PIN, OUTPUT);
  FREQ = steps*microsteps;
  halfPeriod = (1000 / FREQ) / 2;  // Half period in ms
  state = 0;
  if(halfPeriod <1){
    halfPeriod = 1000000/FREQ/2;
    state = 1;
  }
}

void loop() {
  digitalWrite(MF_PIN, HIGH);
  digitalWrite(DR_PIN, HIGH);
  if(state == 0){
    digitalWrite(PIN, HIGH);
    delay(halfPeriod);
    digitalWrite(PIN, LOW);
    delay(halfPeriod);
  }else if(state == 1){
    digitalWrite(PIN, HIGH);
    delayMicroseconds(halfPeriod);
    digitalWrite(PIN, LOW);
    delayMicroseconds(halfPeriod);
  }
  
}
