sneakyginger/Silicone_dispenser/Interface/minimal_dispenseG.py

"""Minimal dispense interface — fill in the body of multi_dispense.

Only the symbols below are referenced by other files (dispensing_job.py,
Interface_rpi.py). Anything beyond this is internal to your implementation.
"""

import time

import RPi.GPIO as GPIO

import saved_settings
import scale_sensor


# --- Module attributes read or written by other files -----------------------

density_of_liquid = 1.06  # g/ml — read by dispensing_job and Interface_rpi
                          # (used to convert grams ↔ ml for bucket bookkeeping).

keyboard_weight_entry = False  # dispensing_job sets this to False before each job.
manual_sensor = keyboard_weight_entry  # backwards-compatible alias.


# --- Hardware pins / tuning -------------------------------------------------

STEPPER_PINS = [7, 11, 13, 15]   # BOARD pin per motor (1..4)
MF_PIN = 16                      # microstep-full pin
DIR_PIN = 18                     # direction pin
STEP_DELAY = 0.02                # seconds per microstep pulse
MICROSTEPS_PER_GRAM = 82.47      # calibrated: 5000 steps → 60.627 g
MIN_STEPS = 40                   # minimum microsteps per pulse to overcome pump backlash

SERVO_PINS = [12, 32, 35, 33]    # BOARD pin per servo (1..4)
SERVO_ANGLE_DISPENSE = 90        # degrees for the "dispense" position
SERVO_ANGLE_MIX = 0              # degrees for the "mix" position


calibration_steps_percentage = 0.9
dispensing_steps_percentage = 0.8


# --- Helpers available to your implementation -------------------------------

def measure_weight():
    """Return the current scale reading in grams."""
    if keyboard_weight_entry:
        return float(input("Enter current scale reading (g): "))
    return scale_sensor.read_weight()


def move_stepper(motor_id, microsteps):
    """Pulse stepper `motor_id` (1..4) for `microsteps` steps."""
    pin = STEPPER_PINS[motor_id - 1]
    GPIO.setmode(GPIO.BOARD)
    GPIO.setup(pin, GPIO.OUT)
    GPIO.setup(MF_PIN, GPIO.OUT); GPIO.output(MF_PIN, 1)
    GPIO.setup(DIR_PIN, GPIO.OUT); GPIO.output(DIR_PIN, 0)
    for _ in range(int(microsteps)):
        GPIO.output(pin, 1); time.sleep(STEP_DELAY / 2)
        GPIO.output(pin, 0); time.sleep(STEP_DELAY / 2)
    GPIO.output(DIR_PIN, 1)
    if microsteps > 110:
        i = 0
    else:
        i = 100-microsteps+70
    while i<=100:
        GPIO.output(pin, 1)
        time.sleep(0.015 / 2)
        GPIO.output(pin, 0)
        time.sleep(0.015 / 2)
        i+=1
    GPIO.output(DIR_PIN, 0)
    GPIO.output(MF_PIN, 0) # Disable steppers


_servo_pwms = None

def set_servos(positions):
    """Move the 4 servos. `positions` is a list of 4 ints: 0=dispense, 1=mix."""
    assert len(positions) == 4 and all(p in (0, 1) for p in positions)
    angles = [SERVO_ANGLE_DISPENSE if p == 0 else SERVO_ANGLE_MIX for p in positions]
    global _servo_pwms
    if _servo_pwms is None:
        GPIO.setmode(GPIO.BOARD)
        _servo_pwms = []
        for pin in SERVO_PINS:
            GPIO.setup(pin, GPIO.OUT)
            _servo_pwms.append(GPIO.PWM(pin, 50))  # 50 Hz servo signal
    for i, (pwm, angle, p) in enumerate(zip(_servo_pwms, angles, positions), start=1):
        duty = 2.5 + (angle / 180) * (13.5 - 2.5)
        pwm.start(duty)
        action = "opening (dispense)" if p == 0 else "closing (mix)"
    time.sleep(2)  # let servos physically reach their position
    for pwm in _servo_pwms:
        pwm.stop()  # fully halt PWM thread; restarted next call via .start()


# --- The one function other files call --------------------------------------

def multi_dispense(amounts, progress_callback=None, progress_interval=10):
    start_time = time.perf_counter()
    # Report progress to the UI by calling, at most once per `progress_interval` seconds:
    #     progress_callback(component_index, grams_dispensed_so_far)
    for i, amount in enumerate(amounts):
        if amount > 0:
            dispense_1comp(i + 1, amount, progress_callback)
    elapsed_time = time.perf_counter() - start_time
    print(f"multi_dispense completed in {elapsed_time:.2f} seconds.")


def dispense_1comp(bucket_id, amount, progress_callback=None, progress_interval=10):
    # First pulse dispenses ~50% of `amount` using the saved bucket calibration,
    # then we recompute steps-per-gram from the actual delta and use that
    # for the rest of this call and future calls for the same bucket.
    print(f"\n>>> dispense_1comp called: bucket={bucket_id}, amount={amount} g")

    start_weight = measure_weight()
    target = start_weight + amount
    last_report = 0.0
    print(f"    start_weight={start_weight:.3f} g, target={target:.3f} g")

    positions = [1, 1, 1, 1]
    positions[bucket_id - 1] = 0
    set_servos(positions)

    saved_steps_per_gram = saved_settings.bucket_microsteps_per_gram(bucket_id - 1)

    # --- Calibration pulse: dispense ~50% using the bucket's last saved rate ---
    cal_steps = max(MIN_STEPS, int(amount * calibration_steps_percentage * saved_steps_per_gram))
    print(f"calibration pulse: motor {bucket_id} for {cal_steps} microsteps (~{calibration_steps_percentage*100:.0f}% of {amount:.2f} g)")
    move_stepper(bucket_id, cal_steps)
    time.sleep(1)
    positions = [1, 1, 1, 1]
    set_servos(positions)
    after_cal = measure_weight()


    delta = after_cal - start_weight
    if delta > 0.01:
        steps_per_gram = cal_steps / delta
        if(steps_per_gram < saved_steps_per_gram*1.5):
            saved_settings.set_bucket_microsteps_per_gram(bucket_id - 1, steps_per_gram)
            print(f"    calibrated: {delta:.3f} g in {cal_steps} steps -> {steps_per_gram:.2f} steps/g (previous {saved_steps_per_gram:.2f})")
    else:
        steps_per_gram = saved_steps_per_gram
        print(f"    calibration pulse dispensed too little ({delta:.3f} g); keeping saved {saved_steps_per_gram:.2f} steps/g")

    while True:
        positions = [1, 1, 1, 1]
        time.sleep(1)
        set_servos(positions)
        current = measure_weight()
        remaining = target - current

        progress_callback(bucket_id - 1, current - start_weight)

        if remaining <= 0.05:
            positions = [1, 1, 1, 1]
            set_servos(positions)
            print(f"Finished dispensing component {bucket_id}: target={target:.2f} g, actual={current:.2f} g")
            STEP_DELAY = 0.02
            break

        
        positions[bucket_id - 1] = 0
        set_servos(positions)

        if remaining > 1:
            STEP_DELAY = 0.03
        else:
            STEP_DELAY = 0.04

        
        steps = max(MIN_STEPS, int(remaining * dispensing_steps_percentage * steps_per_gram))
        print(f"moving motor {bucket_id} for {steps} microsteps (remaining: {remaining:.2f} g)")
        move_stepper(bucket_id, steps)

        now = time.monotonic()
        #if progress_callback and (now - last_report) >= progress_interval:
        #    progress_callback(bucket_id - 1, current - start_weight)
        #    last_report = now

    if progress_callback:
        progress_callback(bucket_id - 1, measure_weight() - start_weight)



def circulate(progress_callback=None, progress_interval=1):
    set_servos([1, 1, 1, 1])

    duration_minutes = saved_settings.mixing_settings()["duration_minutes"]
    circulation_microsteps = int((duration_minutes * 60) / STEP_DELAY)
    progress_chunk_steps = max(1, int(progress_interval / STEP_DELAY))

    for bucket_index in range(4):
        grams_remaining = saved_settings.bucket_volume(bucket_index) * density_of_liquid
        if grams_remaining > 0:
            moved_microsteps = 0
            while moved_microsteps < circulation_microsteps:
                chunk_steps = min(progress_chunk_steps, circulation_microsteps - moved_microsteps)
                move_stepper(bucket_index + 1, chunk_steps)
                moved_microsteps += chunk_steps
                if progress_callback:
                    progress_callback(bucket_index, moved_microsteps * STEP_DELAY)
