sneakyginger/Silicone_dispenser/Interface/theme.py

"""Shared fonts and colors for the dispenser interface."""

# Colors
WHITE = (255, 255, 255)
BLACK = (0, 0, 0)
TOP_BAR_BACKGROUND = (10, 10, 10)
TOP_BAR_TEXT = (230, 230, 230)
TOP_BAR_TRACK = (58, 58, 58)
SELECTION_BAR_TRACK = (190, 190, 190)
BUCKET_FULL = (0x2A, 0xB6, 0x46)
BUCKET_NORMAL = (0x1A, 0x60, 0xD8)
BUCKET_LOW = (0xFC, 0x38, 0x34)
WARNING = (200, 0, 0)
CAUTION = (200, 100, 0)

# Font names
SANS_SERIF_FONTS = "sans,arial,liberationsans,helvetica,dejavusans"
SERIF_FONTS = "liberationserif,dejavuserif,timesnewroman,times,serif"
DEFAULT_FONT = SERIF_FONTS
CLOCK_FONTS = "sfprodisplay,sfpro,helveticaneue,helvetica,arial,notosans,liberationsans,dejavusans"

# Interface font sizes
FONT_SIZE_SMALLER = 16
FONT_SIZE_SMALL = 28
FONT_SIZE_NORMAL = 28
FONT_SIZE_BIG = 72

# Top bar font sizes
TOP_BAR_LABEL_FONT_SIZE = 26
TOP_BAR_TEXT_FONT_SIZE = 13
TOP_BAR_TIME_FONT_SIZE = 26
