sneakyginger/Silicone_dispenser/(commit log)

2026-03-05 create environment
    [pyvenv.cfg]
2026-03-06 Peristaltic Pump CAD
2026-03-06 button plaats change
2026-03-06 nema + bracket
    [motor assembly.cfg]
2026-03-06 Rotor Assembly
    [608-2z.cfg, Assembly Rotor.cfg]
2026-03-06 Assembly Rotor
    [608-2z.cfg, Assembly Rotor.cfg]
2026-03-07 Made loading bar + new def
    def available_locations,
    inputs are current cursor location
    key direction i.e. "right"
    locations that should be enabled in this menu i.e. [1,2,4]
2026-03-10 smaller from 80 --> 6 diameter
    [Assembly Rotor.cfg, motor assembly.cfg]
2026-03-11 Pump Housing V1
    [Pump Assembly.cfg]
2026-03-12 2 and 4 component dispensing fixed
    loading bar quicker, removed redundancy
    [Interface.py]
2026-03-12 Einde sessie 12/03 all working
    [pyvenv.cfg]
2026-03-13 ik ben confused
    [pyvenv.cfg]
2026-03-13 nog een test push
2026-03-13 undo nog een test push
2026-03-18 Rotor Change
    [Assembly Rotor.cfg, Pump Assembly.cfg, motor assembly.cfg, tube testing channel.stl]
2026-03-18 Pump Housing V2
    [Pump Assembly.cfg]
2026-03-19 servo shizzle aangepast
    [Parallax-Servo-ASM.cfg, Valve holder v3.stl, servo holder v2.stl, servo holder.stl]
2026-03-20 Pump Redesign
2026-03-20 valve circulation aangepast
    [Valve holder v3.stl, servo holder v4.stl]
2026-03-20 file voor stepper tests
2026-03-20 file voor servo tests
2026-03-20 add component button sprites
2026-03-20 fixed interface menu 8
    [Interface.py]
2026-03-20 mixing toevoegen + servo aansturing verbeteren
2026-03-20 added buttons
2026-03-20 Container Luer
    [Silicone Container.step]
2026-03-23 V2 pump assembly
    [Assembly Rotor.cfg, Luer Lock Test.stl, Pump Assembly V2.cfg, motor assembly.cfg]
2026-03-25 dit is het dave
    [servo holder v4.stl, servo mounting v4.stl, total assembly.cfg, valve circulation ASSEMBLY v2.cfg, valve circulation ASSEMBLY.cfg]
2026-03-26 speedup stepper
2026-03-26 Pump Occlusion Change
    [Assembly Rotor.cfg]
2026-03-27 fixed stepper code
2026-03-27 Servo aandrijving + nieuwe stepper code
2026-04-22 weight sensor
    [weight unit V2.cfg]
2026-04-23 Wirings electronics
2026-04-23 Nema 23 new files
    [Assembly Pump Nema 23.cfg, Assembly Rotor Nema 23.cfg, Assembly Rotor.cfg, Nema 23 .cfg, Pump Assembly V2.cfg, Pump Assembly V3.cfg, Total Assembly (Non-Read-Only.cfg, motor assembly.cfg]
2026-04-24 move servo readme
2026-04-25 encoder fie made
2026-04-26 Housing Update
    [Assembly Pump Nema 23.cfg]
2026-04-29 servo holder
2026-04-29 valve holder
2026-04-30 update servo holder
    [weight unit V5.cfg]
2026-04-30 implemented encoder into RPI interface
2026-04-30 Add comments to pin definitions in Encoder.py
2026-05-01 fix encoder.py
2026-05-01 FSM approach voor encoder.py
2026-05-01 combine both interface versions and working encoder.py
2026-05-01 fix Interface Encoder problems
    [Interface.py]
2026-05-01 remove debug prints
2026-05-06 nieuwe servotest
2026-05-07 Rotor D lock
    [Assembly Rotor Nema 23.cfg]
2026-05-07 sixseven
    sixseven
    [Total Assembly (Non-Read-Only.cfg, Valve circulation bottom.stl, Valve circulation top.stl, Valve circulation tussenstuk.stl, Valve holder V7.stl, frame list kamiel.xlsx, servo holder V12.stl, servo holder V13.stl]
2026-05-07 set RASPBERRY to true
2026-05-07 changed board mode
2026-05-07 skip zero-amount motors and gate dispense to one run
    [Interface_rpi.py, dispense.py]
2026-05-07 pin swap
2026-05-07 per-bucket refill flow + right-click and scroll wheel input
    Refill menu now picks one of A/B/C/D and edits that bucket's volume only;
    hardness stays per-pair. Slider pre-fills with the bucket's current volume.
    Right-click activates the current selection; wheel maps to encoder rotation.
2026-05-08 Revert "per-bucket refill flow + right-click and scroll wheel input"
    This reverts commit accf59dd09a1444ec2568783bbcbb59dc367ac52.
    [Interface_rpi.py]
2026-05-08 Reapply "per-bucket refill flow + right-click and scroll wheel input"
    This reverts commit aa1fc8154e1896d22122f8b093a11ee03f130a49.
    [Interface_rpi.py]
2026-05-08 remove dispensing on a seperate thread
2026-05-08 debug servo prints
2026-05-08 move debug servo prints
2026-05-08 more samples
2026-05-09 made tests for weight sensor
2026-05-11 added print statement + loop
2026-05-12 removed sleep time and prepare for recalibration 10V
2026-05-13 maak servo debugging scripts
2026-05-13 Gebruik bucket1324 ipv componentABCD
2026-05-13 voeg top bar toe om bucket niveaus te displayen en tijd te tonen
2026-05-13 voeg bucket icoon voor top bar toe
2026-05-13 fix het refill scherm, fix de refill bar, maak increment 10ml ipv 1ml, vanaf nu overal hoeveelheid bijhouden als float, maar displayen als een int
    [Interface_rpi.py, theme.py, top_bar.py]
2026-05-13 remove de back knop in home menu
2026-05-13 integreer weight sensor (staat nog op keyboard met een True variable), verbeter selectie sprite, en zet de leeg error lager op een zichbare plaats
    [Interface_rpi.py, dispense.py, scale_sensor.py]
2026-05-13 cartridge_config.json terug in de git, zodat die mee kan aangepast worden met code updates
2026-05-14 was not calibrated
2026-05-14 oneven samples
2026-05-14 precision calibration start
2026-05-14 test calibration
2026-05-14 readded print statement
2026-05-14 test fancyer calibration
2026-05-14 changed calibration
2026-05-14 verbeter servo hoek
2026-05-14 zet op weeg met sensor mode ipv met keyboard mode
2026-05-14 voeg scale sensor test script voor de scale sensor module functie code
2026-05-14 Tube end Holder
2026-05-15 hopelijk een verbetering op dispense.py
2026-05-15 update Interface_rpi.py met de code van de andere branch
2026-05-15 voeg support toe voor de nieuwe dispense file + laat de nieuwe single dispense functie opgeroepen worden vanuit de nieuwe multi dispense
2026-05-15 added total dispens+servo
2026-05-15 jippie calibratie
2026-05-15 new calibration
2026-05-15 add prints
2026-05-15 disable steppers after moving
2026-05-15 changed button
2026-05-15 pin uppercase
2026-05-15 encoder pins veranderen
2026-05-15 added print
2026-05-15 test servotest
2026-05-15 minimal_dispenseN2 aan het funetunen
2026-05-16 gebruik de kalibratie van vorige dispense als deze default kalibratie
2026-05-16 5 options on screen 1; recentering, commenting unused functions, placing text so in doesn't get covered by top bar
    [Interface_rpi.py, dispenser.py, mixing_settings_form.py, theme.py]
2026-05-17 fixed height to account for top bar
    [Interface_rpi.py]
2026-05-17 final assembly
    [Ecran Raspberry Pi4 5 pouces 800x600.STEP, Ecran Raspberry Pi4 5 pouces 800x600.cfg, PowerSupply_48V_DC_5A.STEP, Total Assembly V1.cfg, VTX-212-150-0xx.STEP, Valve circulation assembly V3.cfg, user interaction unit.cfg]
2026-05-17 fixed framerate
2026-05-17 new asseùbly
    [Ecran Raspberry Pi4 5 pouces 800x600.cfg, Total Assembly V1.cfg, Valve circulation assembly V3.cfg]
2026-05-17 slower framerate
2026-05-18 implementeer de manuele circulatie functie
2026-05-18 calibration ofset
2026-05-18 removed one servo change
2026-05-18 update turn stepper om stepper te kunnen kiezen
2026-05-19 change servo range
2026-05-19 servo duty change
2026-05-19 meer in een keer dispensen
2026-05-19 fix ook de servo ding op het einde bij de N2 code
    [minimal_dispenseN2.py]
2026-05-19 measure dispense time & print
2026-06-22 Map Alexis
    [5mm-3mm Restrictor.f3d, Assembly Pump Nema 23.cfg, Cover Silicone Container.f3d, Silicone Container.f3d]
